sheminasalam/OverKill-Smart-IR-Hub/hardware/Overkill_marketing_collage.png

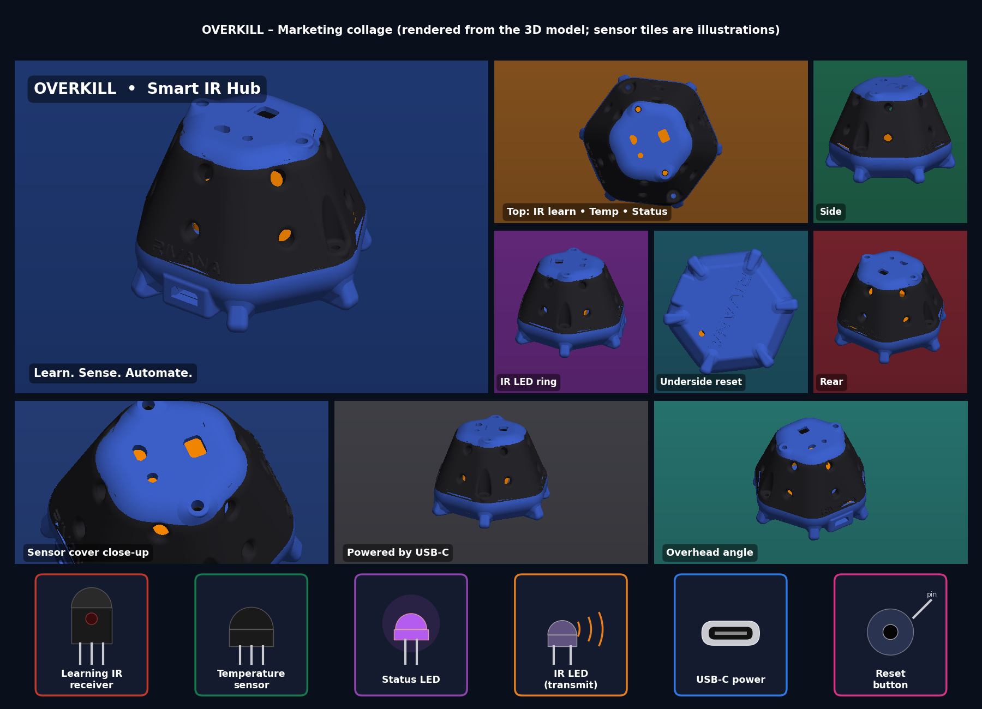
hardware/Overkill_marketing_collage.png
