sheminasalam/OverKill-Smart-IR-Hub/3d_printing/Overkill.3mf

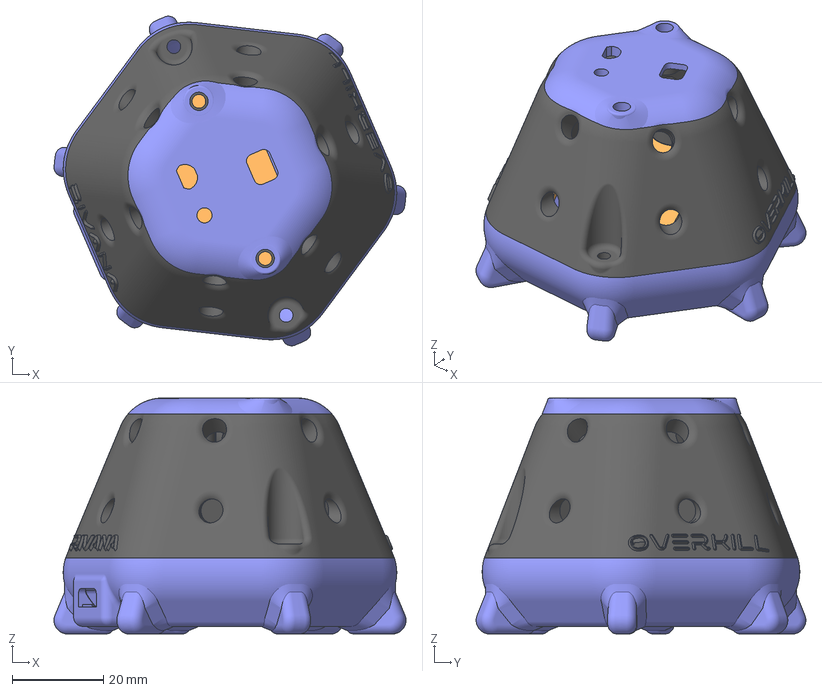
[picture p4: CAD file, 2026-10-25]
3d_printing/Overkill.3mf
77.1 x 72.2 x 51.7 mm
