sheminasalam/OverKill-Smart-IR-Hub/firmware/OverKill-v1.ino

#include <Arduino.h>
#include <EEPROM.h>
#include <ESP8266WiFi.h>
#include <WiFiUdp.h>
#include <PubSubClient.h>
#include <cstring>
#include <cstddef>
#include <cstdlib>
#include <SPI.h>
#include <IRremoteESP8266.h>
#include <IRrecv.h>
#include <IRsend.h>
#include <IRutils.h>
#include <time.h>
#include <ESP8266WebServer.h>
#include <ESP8266HTTPUpdateServer.h>
#include "captive_dns.h"
// >>> v11 INTEGRATION
#include "webui_html.h"

struct DatabaseHeader;
struct StorageRecordHeader;
struct FormatIntent;
enum class StableReadResult : uint8_t;
enum class PayloadVerifyResult : uint8_t;
enum class FormatIntentFindResult : uint8_t;
enum class DeviceLookupResult : uint8_t;
struct HueCommandMapEntry;
struct RuleStep;
struct RuleTriggerStored;
struct StoredRule;
struct LegacyStoredRule;
struct RuleTriggerRuntime;
struct RuleSlot;
struct StoredSchedule;
struct AutomationScheduleState;
struct AutomationJob;

#ifndef _IRREMOTEESP8266_VERSION
  #error "IRremoteESP8266 version macro not found. Install IRremoteESP8266 v2.9.0."
#endif
static_assert(
  _IRREMOTEESP8266_VERSION == _IRREMOTEESP8266_VERSION_VAL(2, 9, 0),
  "Stage 1 requires IRremoteESP8266 v2.9.0"
);

#define FIRMWARE_NAME    "ESP8266 Universal IR Hub"
#define FIRMWARE_VERSION "Overkill v2.0"

#define STAGE1_SERIAL_DEBUG 1

bool serialEnabled = true;

#if STAGE1_SERIAL_DEBUG
  #define DBG_PRINT(...)      do { if (serialEnabled) Serial.print(__VA_ARGS__); } while (0)
  #define DBG_PRINTLN(...)    do { if (serialEnabled) Serial.println(__VA_ARGS__); } while (0)
  #define DBG_PRINTLN_EMPTY() do { if (serialEnabled) Serial.println(); } while (0)
#else
  #define DBG_PRINT(...)      do {} while (0)
  #define DBG_PRINTLN(...)    do {} while (0)
  #define DBG_PRINTLN_EMPTY() do {} while (0)
#endif

// ============================================================
// FINAL GPIO ASSIGNMENT
// ============================================================

constexpr uint8_t PIN_FLASH_MISO   = 12;
constexpr uint8_t PIN_FLASH_MOSI   = 13;
constexpr uint8_t PIN_FLASH_SCLK   = 14;
constexpr uint8_t PIN_FLASH_CS     = 3;

constexpr uint8_t PIN_IR_TX_DEFAULT      = 4;
constexpr uint8_t PIN_IR_RX_DEFAULT      = 5;
constexpr uint8_t PIN_STATUS_LED_DEFAULT = 2;
constexpr uint8_t PIN_DS18B20_DEFAULT    = 16;

uint8_t pinIrTx      = PIN_IR_TX_DEFAULT;
uint8_t pinIrRx      = PIN_IR_RX_DEFAULT;
uint8_t pinStatusLed = PIN_STATUS_LED_DEFAULT;
uint8_t pinDs18b20   = PIN_DS18B20_DEFAULT;

static_assert(PIN_FLASH_MISO != PIN_FLASH_MOSI, "GPIO overlap");
static_assert(PIN_FLASH_MISO != PIN_FLASH_SCLK, "GPIO overlap");
static_assert(PIN_FLASH_MISO != PIN_FLASH_CS, "GPIO overlap");
static_assert(PIN_FLASH_MOSI != PIN_FLASH_SCLK, "GPIO overlap");
static_assert(PIN_FLASH_MOSI != PIN_FLASH_CS, "GPIO overlap");
static_assert(PIN_FLASH_SCLK != PIN_FLASH_CS, "GPIO overlap");

// ============================================================
// IR RECEIVER CONFIGURATION
// ============================================================

constexpr uint16_t RAW_WAVEFORM_CAPACITY = 1024;
constexpr uint16_t IRRECV_BUFFER_SIZE = RAW_WAVEFORM_CAPACITY + 1;
constexpr uint16_t CAPTURE_TIMEOUT_MS = 50;
constexpr bool     SAVE_BUFFER         = false;

static_assert(CAPTURE_TIMEOUT_MS <= UINT8_MAX,
              "CAPTURE_TIMEOUT_MS exceeds IRremoteESP8266 uint8_t limit");

constexpr uint32_t LEARN_SESSION_TIMEOUT_MS = 15000UL;

uint16_t txFrequencyHz = 38000;
uint8_t  txRepeatCount = 1;
uint16_t txRepeatGapMs = 100;

constexpr uint16_t MIN_TX_FREQUENCY_HZ = 10000;
constexpr uint16_t MAX_TX_FREQUENCY_HZ = UINT16_MAX;

constexpr uint16_t TX_WDT_FEED_INTERVAL = 16;
static_assert(TX_WDT_FEED_INTERVAL > 0,
              "TX_WDT_FEED_INTERVAL must be greater than zero");

IRrecv *irrecvPtr = nullptr;
IRsend *irsendPtr = nullptr;
decode_results results;
bool irReceiverActive = false;

enum class IrEngineState : uint8_t {
  IDLE,
  LEARNING,
  TRANSMITTING
};
IrEngineState irState = IrEngineState::IDLE;

static uint16_t lastRaw[RAW_WAVEFORM_CAPACITY];
uint16_t lastRawLen = 0;
uint32_t lastRawCrc32 = 0;

// Shared staging buffer used by both the IR capture path (during learn)
// and the storage record path (during load/save/rename). The two
// subsystems are active at different times, so a single aligned buffer
// replaces what used to be two separate 2 KB buffers (stagingRaw plus
// storageRecordBuffer). Sized for the maximum storage record: header
// + name + 1024-word waveform. The exact value is verified by a
// static_assert() in the storage section further down.
static constexpr size_t SHARED_RECORD_BUFFER_BYTES = 2123;
alignas(4) static uint8_t storageRecordBuffer[SHARED_RECORD_BUFFER_BYTES];

// Metadata captured at the same moment as a successful IR learn. This keeps
// the command's transmit parameters tied to the learned waveform instead of
// whatever happens to be in the mutable TX globals when the save occurs.
static uint16_t lastLearnCarrierHz = 38000U;
static uint8_t  lastLearnRepeatCount = 1U;
static uint16_t lastLearnRepeatGapMs = 100U;
static bool     lastLearnMetadataValid = false;

struct IrStatistics {
  uint32_t learnAttempts = 0;
  uint32_t successfulLearns = 0;
  uint32_t learnTimeouts = 0;
  uint32_t learnOverflows = 0;
  uint32_t malformedCaptures = 0;
  uint32_t storeFailures = 0;
  uint32_t transmissionsStarted = 0;
  uint32_t transmissionsCompleted = 0;
  uint32_t transmissionRejected = 0;
  uint16_t maxCapturedRawLen = 0;
  uint16_t maxStoredRawLen = 0;
  uint32_t maxWaveformDurationUs = 0;
};
IrStatistics irStats;

#if STAGE1_SERIAL_DEBUG
uint32_t minFreeHeap = UINT32_MAX;
#endif

// ============================================================
// STAGE 3 HARDWARE SERVICES
// ============================================================

constexpr bool     DS18B20_ENABLED_DEFAULT = true;
constexpr uint32_t DS18B20_SAMPLE_INTERVAL_DEFAULT_MS = 10000UL;
constexpr uint32_t DS18B20_SAMPLE_INTERVAL_MIN_MS = 1000UL;
constexpr uint32_t DS18B20_SAMPLE_INTERVAL_MAX_MS = 3600000UL;
constexpr uint32_t DS18B20_CONVERSION_WAIT_MS = 800UL;
constexpr uint32_t DS18B20_RETRY_INTERVAL_MS = 5000UL;

struct DS18B20State {
  bool enabled = DS18B20_ENABLED_DEFAULT;
  bool connected = false;
  bool conversionPending = false;
  bool temperatureValid = false;
  int16_t rawTemperature = 0;
  int16_t calibrationCentiDegrees = 0;
  int32_t calibratedTemperatureCentiDegrees = 0;
  uint32_t conversionStartedMs = 0;
  uint32_t sampleIntervalMs = DS18B20_SAMPLE_INTERVAL_DEFAULT_MS;
  uint32_t nextActionMs = 0;
  uint32_t lastReadMs = 0;
  uint32_t sampleSequence = 0;
};
DS18B20State ds18b20State;

enum class StatusLedMode : uint8_t { OFF, LEARNING, ERROR };
StatusLedMode statusLedMode = StatusLedMode::OFF;
bool statusLedOn = false;
bool statusLedPulsePending = false;
bool statusLedErrorActive = false;
bool statusLedManualErrorActive = false;
bool statusLedStorageErrorActive = false;
bool statusLedWifiErrorActive = false;
bool statusLedMqttErrorActive = false;
uint32_t statusLedNextToggleMs = 0;
uint32_t statusLedPulseUntilMs = 0;


enum class WifiRecoveryState : uint8_t { OFF, AP };
enum class DiscoveryMode : uint8_t { NATIVE_HA = 0, CUSTOM = 1 };
DiscoveryMode discoveryMode = DiscoveryMode::CUSTOM;
void mqttSetDiscoveryMode(DiscoveryMode mode);
void mqttClearAllDiscoveryRetained();
void mqttClearAlexaCatalogRetained();
WifiRecoveryState wifiRecoveryState = WifiRecoveryState::OFF;
uint32_t wifiRecoveryNotConnectedSinceMs = 0UL;
char     wifiRecoveryApSsid[24] = {0};
uint32_t wifiRecoveryApConnectedAtMs = 0UL;   // 0 = not yet connected
constexpr uint32_t WIFI_AP_GRACE_PERIOD_MS = 300000UL;   // 5 minutes

constexpr uint32_t WIFI_RECOVERY_TRIGGER_MS = 30000UL;

constexpr uint32_t STATUS_LED_LEARN_BLINK_MS = 300UL;
constexpr uint32_t STATUS_LED_ERROR_BLINK_MS = 1000UL;
constexpr uint32_t STATUS_LED_TX_PULSE_MS = 120UL;

void statusLedInitialize();
void statusLedSetError(bool active);
void statusLedSetStorageError(bool active);
void statusLedSetWifiError(bool active);
void statusLedSetMqttError(bool active);
void statusLedStartLearning();
void statusLedStopLearning();
void statusLedPulseTransmit();
void statusLedService();
void statusLedServiceLearningWait();
void statusLedServiceWifiErrorDelay();   // >>> v1.0 delayed WiFi error LED
void statusLedPrintStatus();
void rebootDevice();

// ============================================================
// WI-FI FOUNDATION
// ============================================================

constexpr size_t WIFI_SSID_MAX_LENGTH = 32U;
constexpr size_t WIFI_PASSWORD_MAX_LENGTH = 63U;
constexpr size_t WIFI_HOSTNAME_MAX_LENGTH = 32U;
constexpr uint32_t WIFI_CONNECT_TIMEOUT_MS = 15000UL;
constexpr uint32_t WIFI_RECONNECT_INTERVAL_MS = 5000UL;

enum class WifiState : uint8_t {
  UNCONFIGURED, CONNECTING, CONNECTED, DISCONNECTED
};

struct WifiConfiguration {
  char ssid[WIFI_SSID_MAX_LENGTH + 1U] = {0};
  char password[WIFI_PASSWORD_MAX_LENGTH + 1U] = {0};
  char hostname[WIFI_HOSTNAME_MAX_LENGTH + 1U] = {0};
};

struct StaticIpConfig {
  bool      enabled = false;
  IPAddress ip;
  IPAddress gateway;
  IPAddress subnet;
  IPAddress dns;
};
StaticIpConfig staticIpConfig;
static bool lastAppliedStaticIpMode = false;

// ── WebUI hub name (shared by WebUI and MQTT discovery) ─────
constexpr size_t WEBUI_HUB_NAME_MAX = 32U;
char webUiHubName[WEBUI_HUB_NAME_MAX + 1U] = "Universal IR Hub";


WifiConfiguration wifiConfig;
WifiState wifiState = WifiState::UNCONFIGURED;
bool wifiConnectAttemptActive = false;
// ── Wi-Fi recovery AP state (v1.0) ───────────────────────────
bool wifiConfigurationDirty = false;
uint32_t wifiConnectStartedMs = 0UL;
uint32_t wifiNextReconnectMs = 0UL;
uint8_t wifiLastStatus = 0U;

void wifiInitialize();
void wifiService();
void wifiPrintStatus();
bool wifiSetSSID(const char *ssid);
bool wifiSetPassword(const char *password);
bool wifiSetHostname(const char *hostname);
bool wifiApplyConfiguration();
bool wifiIsConfigured();
bool wifiIsConnected();
const char *wifiGetSSID();
bool wifiPasswordIsConfigured();
int32_t wifiGetRSSI();

void configurationStorageInitialize();
bool configurationLoadWifi();
bool configurationSaveWifi();
bool configurationLoadMqtt();
bool configurationLoadStaticIp();          // ← new
bool configurationSaveStaticIp();          // ← new
bool configurationSaveMqtt();
bool configurationLoadHa();
bool configurationSaveHa();
bool configurationLoadPins();
bool configurationSavePins();
bool configurationLoadSystem();
bool configurationSaveSystem();
bool configurationInitializeCommandHue(uint32_t databaseGeneration);
bool storageGetCommandHueEnabled(uint32_t commandId, bool &enabledOut);
bool storageSetCommandHueEnabled(uint32_t commandId, bool enabled);
bool configurationInitializeDeviceCloud(uint32_t databaseGeneration);
bool storageGetDeviceCloud(uint32_t deviceId, uint8_t &categoryOut, bool &cloudOut);
bool storageSetDeviceCloud(uint32_t deviceId, uint8_t category, bool cloud);
const char *deviceCategoryName(uint8_t category);
uint8_t deviceCategoryFromName(const char *name);
void hueInvalidateCache();
bool configurationLoadTempCal();
bool configurationSaveTempCal();

void hueInitialize();
void hueService();
void hueStopNetworking();   // >>> v1.0 watchdog needs this declared early

void mqttRequestDiscoveryRefresh();
bool mqttDiscoveryClearAllCommandConfigs();
bool mqttRemoveHaTemperatureDiscovery();
bool mqttRemoveHaButtonDiscovery(uint32_t commandId);   // >>> ADD

void mqttInitialize();
void mqttService();
void mqttPrintStatus();
bool mqttSetEnabled(bool enabled);
bool mqttSetBroker(const char *broker);
bool mqttSetPort(uint16_t port);
bool mqttSetUsername(const char *username);
bool mqttSetPassword(const char *password);
bool mqttSetClientId(const char *clientId);
bool mqttSetBaseTopic(const char *baseTopic);
bool mqttApplyConfiguration();
bool mqttIsConnected();
const char *mqttGetBaseTopic();
bool mqttHaDiscoverySetEnabled(bool enabled);

// >>> v11 INTEGRATION — WebUI forward declarations
bool webUiLoadHubName();
bool webUiPersistHubName();
const char *webUiIrStateToString(IrEngineState state);
bool parseUint32Text(const char *text, uint32_t &valueOut);
bool webUiParseAutomationCommand(const char *cmd, char *errOut, size_t errCap);
bool webUiDispatch(WiFiClient &client, const char *method, const char *path, const char *body);
// Used by the WiFi watchdog to avoid false positives during a scan.
bool webUiWifiScanInProgress();

// Config backup / restore to the W25Qxx flash.
bool storageWriteConfigBackup();
bool storageReadConfigBackup(uint8_t *out, size_t capacity);

// Per-entity settings on SPI (Stage 2 live path).
bool storageGetDeviceSettings(uint32_t deviceId, uint8_t &categoryOut, bool &cloudOut);
bool storageSetDeviceSettings(uint32_t deviceId, uint8_t category, bool cloud);
bool storageGetCommandAlexa(uint32_t commandId, bool &alexaOut);
bool storageSetCommandAlexa(uint32_t commandId, bool alexaOn);

bool copyWifiField(char *destination, size_t destinationCapacity, const char *source) {
  if (destination == nullptr || source == nullptr || destinationCapacity < 2U) return false;
  const size_t length = strlen(source);
  if (length == 0U || length >= destinationCapacity) return false;
  memcpy(destination, source, length + 1U);
  return true;
}

bool wifiHostnameIsValid(const char *hostname) {
  if (hostname == nullptr) return false;
  const size_t length = strlen(hostname);
  if (length == 0U || length > WIFI_HOSTNAME_MAX_LENGTH) return false;
  if (hostname[0] == '-' || hostname[length - 1U] == '-') return false;
  for (size_t i = 0; i < length; i++) {
    const char c = hostname[i];
    const bool valid = (c >= 'a' && c <= 'z') || (c >= 'A' && c <= 'Z') ||
                       (c >= '0' && c <= '9') || c == '-';
    if (!valid) return false;
  }
  return true;
}

const char *wifiStateToString(WifiState state) {
  switch (state) {
    case WifiState::UNCONFIGURED: return "UNCONFIGURED";
    case WifiState::CONNECTING:   return "CONNECTING";
    case WifiState::CONNECTED:    return "CONNECTED";
    case WifiState::DISCONNECTED: return "DISCONNECTED";
    default:                      return "UNKNOWN";
  }
}

void wifiUpdateStateFromHardware() {
  if (wifiConfig.ssid[0] == '\0') { wifiState = WifiState::UNCONFIGURED; return; }
  const wl_status_t currentStatus = WiFi.status();
  wifiLastStatus = static_cast<uint8_t>(currentStatus);
  if (currentStatus == WL_CONNECTED) {
    wifiState = WifiState::CONNECTED;
    wifiConnectAttemptActive = false;
  } else if (wifiConnectAttemptActive) {
    wifiState = WifiState::CONNECTING;
  } else {
    wifiState = WifiState::DISCONNECTED;
  }
}

static void wifiApplyIpConfiguration() {
  const bool useStatic = staticIpConfig.enabled &&
      static_cast<uint32_t>(staticIpConfig.ip) != 0U &&
      static_cast<uint32_t>(staticIpConfig.gateway) != 0U &&
      static_cast<uint32_t>(staticIpConfig.subnet) != 0U;
  if (useStatic) {
    const IPAddress dns = (static_cast<uint32_t>(staticIpConfig.dns) != 0U)
                          ? staticIpConfig.dns : staticIpConfig.gateway;
    if (!WiFi.config(staticIpConfig.ip, staticIpConfig.gateway,
                     staticIpConfig.subnet, dns)) {
      Serial.println(F("WARNING: static IP config rejected; using DHCP instead."));
    }
  } else {
    // Do NOT call WiFi.config(0,0,0,0) here. On ESP8266 core that does
    // not reliably revert a previously-latched static IP. The netif reset
    // in wifiStartConnection() handles the DHCP case instead.
  }
}

void wifiStartConnection() {
  if (wifiConfig.ssid[0] == '\0') {
    wifiConnectAttemptActive = false;
    wifiState = WifiState::UNCONFIGURED;
    statusLedSetWifiError(false);
    return;
  }

  // Detect IP-mode change. On ESP8266 a previously-applied static IP stays
  // latched in LwIP even across WiFi.disconnect(). The only reliable way to
  // switch between static and DHCP is a full netif reset via mode(WIFI_OFF).
  const bool wantStatic = staticIpConfig.enabled &&
      static_cast<uint32_t>(staticIpConfig.ip) != 0U &&
      static_cast<uint32_t>(staticIpConfig.gateway) != 0U &&
      static_cast<uint32_t>(staticIpConfig.subnet) != 0U;
  if (wantStatic != lastAppliedStaticIpMode) {
    WiFi.persistent(false);
    WiFi.disconnect(true);
    delay(100);
    WiFi.mode(WIFI_OFF);
    delay(100);
  }
  lastAppliedStaticIpMode = wantStatic;

  WiFi.mode((wifiRecoveryState != WifiRecoveryState::OFF) ? WIFI_AP_STA : WIFI_STA);
  WiFi.setSleepMode(WIFI_NONE_SLEEP);
  WiFi.hostname(wifiConfig.hostname);
  WiFi.disconnect();
  delay(1);

  wifiApplyIpConfiguration();

  WiFi.begin(wifiConfig.ssid, wifiConfig.password);
  wifiConnectAttemptActive = true;
  wifiConnectStartedMs = millis();
  wifiNextReconnectMs = 0UL;
  wifiLastStatus = static_cast<uint8_t>(WiFi.status());
  wifiState = WifiState::CONNECTING;
}

void wifiInitialize() {
  wifiConfig = WifiConfiguration{};
  snprintf(wifiConfig.hostname, sizeof(wifiConfig.hostname),
           "ir-hub-%06X",
           static_cast<unsigned int>(ESP.getChipId() & 0xFFFFFFUL));
  (void)configurationLoadWifi();
  WiFi.persistent(false);
  WiFi.mode(WIFI_OFF);
  wifiState = WifiState::UNCONFIGURED;
  wifiConnectAttemptActive = false;
  wifiConfigurationDirty = false;
  wifiConnectStartedMs = 0UL;
  wifiNextReconnectMs = 0UL;
  wifiLastStatus = static_cast<uint8_t>(WiFi.status());
  statusLedSetWifiError(false);
}

bool wifiStatusIndicatesConnectionFailure(wl_status_t status) {
  if (status == WL_CONNECT_FAILED || status == WL_NO_SSID_AVAIL) return true;
#ifdef WL_CONNECT_WRONG_PASSWORD
  if (status == WL_CONNECT_WRONG_PASSWORD) return true;
#endif
  return false;
}

// ============================================================
// Wi-Fi liveness watchdog (v2)
// ============================================================
// The previous implementation probed the DHCP-provided DNS server with a
// hand-rolled UDP/53 packet. Home routers commonly drop or rewrite those
// packets, so the probe always timed out and the watchdog killed a healthy
// link every 15 seconds.
//
// This version:
//   * probes a well-known public NTP server by hardcoded IP (no DNS at all)
//   * sends one query every 30 s
//   * declares the link dead only after 3 consecutive misses (~90 s)
//   * refuses to fire if an HTTP client is mid-request
//   * resets state cleanly on every WiFi reconnect

WiFiUDP  wifiWatchdogUdp;
IPAddress wifiWatchdogTarget(162, 159, 200, 1);   // time.cloudflare.com (anycast)
bool     wifiWatchdogSocketOpen        = false;
uint32_t wifiWatchdogLastSendMs        = 0UL;
uint32_t wifiWatchdogLastRecvMs        = 0UL;
uint8_t  wifiWatchdogConsecutiveMisses = 0U;
bool     wifiWatchdogProbeOutstanding  = false;   // >>> v1.0 tighter watchdog

constexpr uint32_t WIFI_WATCHDOG_SEND_INTERVAL_MS = 30000UL;  // 30 s between probes
constexpr uint32_t WIFI_WATCHDOG_RECV_TIMEOUT_MS  = 30000UL;  // reply window
constexpr uint8_t  WIFI_WATCHDOG_MAX_MISSES       = 3U;       // 3 × 30 s ≈ 90 s

// Declared in the Hue module; true when an HTTP client is being served.
extern bool hueHttpClientActive;

void wifiForceHardReset() {
  Serial.println(F("WiFi watchdog: forcing hard reassociation"));
  WiFi.disconnect(true);
  delay(100);
  WiFi.mode(WIFI_OFF);
  delay(100);
  WiFi.mode(WIFI_STA);
  WiFi.setSleepMode(WIFI_NONE_SLEEP);
  if (wifiConfig.hostname[0] != '\0') WiFi.hostname(wifiConfig.hostname);
  wifiApplyIpConfiguration();
  lastAppliedStaticIpMode = staticIpConfig.enabled &&
      static_cast<uint32_t>(staticIpConfig.ip) != 0U;
  WiFi.begin(wifiConfig.ssid, wifiConfig.password);
  wifiConnectAttemptActive      = true;
  wifiConnectStartedMs          = millis();
  wifiNextReconnectMs           = 0UL;
  wifiState                     = WifiState::CONNECTING;
  wifiWatchdogSocketOpen        = false;
  wifiWatchdogLastSendMs        = 0UL;
  wifiWatchdogLastRecvMs        = 0UL;
  wifiWatchdogConsecutiveMisses = 0U;
  hueStopNetworking();
}

void wifiWatchdogSendNtpProbe() {
  if (!wifiWatchdogSocketOpen) {
    if (!wifiWatchdogUdp.begin(0)) return;
    wifiWatchdogSocketOpen = true;
  }
  // Minimal NTPv4 client request: LI=0, VN=4, Mode=3 → 0x23.
  // All other fields zero, which is acceptable for a liveness probe.
  uint8_t packet[48] = {0};
  packet[0] = 0x23;
  wifiWatchdogUdp.beginPacket(wifiWatchdogTarget, 123);
  wifiWatchdogUdp.write(packet, sizeof(packet));
  wifiWatchdogUdp.endPacket();
}

void wifiWatchdogService() {
  // Never touch WiFi while an OTA update is in flight. The transfer
  // saturates the radio, so NTP probes cannot be answered inside the
  // 30 s window and the watchdog would force-reset WiFi mid-upload.
  if (Update.isRunning()) {
    wifiWatchdogConsecutiveMisses = 0U;
    wifiWatchdogProbeOutstanding  = false;
    wifiWatchdogLastSendMs        = millis();
    return;
  }
  // WiFi scan parks the radio on one channel at a time. NTP replies
  // arriving on a different channel are missed. Treat a scan in
  // progress as "radio busy" and hold the miss counter.
  if (webUiWifiScanInProgress()) {
    wifiWatchdogConsecutiveMisses = 0U;
    wifiWatchdogProbeOutstanding  = false;
    wifiWatchdogLastSendMs        = millis();
    return;
  }
  if (!wifiIsConnected()) {
    wifiWatchdogSocketOpen        = false;
    wifiWatchdogLastSendMs        = 0UL;
    wifiWatchdogLastRecvMs        = 0UL;
    wifiWatchdogConsecutiveMisses = 0U;
    wifiWatchdogProbeOutstanding  = false;
    return;
  }

  const uint32_t now = millis();

  // First tick after a successful connect: seed timers, send a probe now.
  if (wifiWatchdogLastRecvMs == 0UL) {
    wifiWatchdogLastRecvMs = now;
    wifiWatchdogLastSendMs = now - WIFI_WATCHDOG_SEND_INTERVAL_MS;
    return;
  }

  // Any datagram back = link alive. Clear the miss counter and mark the
  // outstanding probe as answered.
  if (wifiWatchdogSocketOpen && wifiWatchdogUdp.parsePacket() > 0) {
    while (wifiWatchdogUdp.available()) (void)wifiWatchdogUdp.read();
    if (wifiWatchdogConsecutiveMisses > 0U) {
      Serial.print(F("WiFi watchdog: link recovered after "));
      Serial.print(wifiWatchdogConsecutiveMisses);
      Serial.println(F(" unanswered probe(s)"));
    }
    wifiWatchdogConsecutiveMisses = 0U;
    wifiWatchdogProbeOutstanding  = false;
  }

  // Time to send the next probe?
  if ((now - wifiWatchdogLastSendMs) >= WIFI_WATCHDOG_SEND_INTERVAL_MS) {
    // If the previous probe was never answered by now, count one miss.
    if (wifiWatchdogProbeOutstanding) {
      wifiWatchdogConsecutiveMisses++;
      Serial.print(F("WiFi watchdog: probe miss "));
      Serial.print(wifiWatchdogConsecutiveMisses);
      Serial.print('/');
      Serial.println(WIFI_WATCHDOG_MAX_MISSES);

      if (wifiWatchdogConsecutiveMisses >= WIFI_WATCHDOG_MAX_MISSES) {
        if (hueHttpClientActive || Update.isRunning()) {
          // Do not kill an in-flight HTTP request or OTA write.
          wifiWatchdogConsecutiveMisses = WIFI_WATCHDOG_MAX_MISSES - 1U;
        } else {
          wifiForceHardReset();
          return;
        }
      }
    }

    wifiWatchdogLastSendMs        = now;
    wifiWatchdogSendNtpProbe();
    wifiWatchdogProbeOutstanding  = true;
  }
}

void wifiStartRecoveryAp() {
  if (wifiRecoveryState != WifiRecoveryState::OFF) return;

  snprintf(wifiRecoveryApSsid, sizeof(wifiRecoveryApSsid),
           "Overkill-%06X", (unsigned)(ESP.getChipId() & 0xFFFFFFUL));

  WiFi.mode(WIFI_AP_STA);
  WiFi.setSleepMode(WIFI_NONE_SLEEP);
  WiFi.softAP(wifiRecoveryApSsid);
  captiveDnsStart();

  wifiRecoveryState = WifiRecoveryState::AP;
  hueStopNetworking();

  Serial.print(F("Recovery AP started: "));
  Serial.print(wifiRecoveryApSsid);
  Serial.print(F(" @ "));
  Serial.println(WiFi.softAPIP());
}

// Runs on every idle tick of wifiService(), regardless of STA state.
// The teardown must not live at the end of wifiService() because the
// WL_CONNECTED branch returns early.
static void wifiServiceApGracePeriod() {
  if (wifiRecoveryState == WifiRecoveryState::OFF) return;
  if (wifiRecoveryApConnectedAtMs == 0UL) return;
  if (Update.isRunning()) return;   // never tear down mid-OTA
  const uint32_t now = millis();
  if ((now - wifiRecoveryApConnectedAtMs) < WIFI_AP_GRACE_PERIOD_MS) return;

  hueStopNetworking();          // close HTTP + SSDP first
  captiveDnsStop();             // close captive DNS UDP
  WiFi.softAPdisconnect(true);  // turn the AP off
  WiFi.mode(WIFI_STA);          // now safe to change mode
  WiFi.setSleepMode(WIFI_NONE_SLEEP);
  wifiRecoveryState = WifiRecoveryState::OFF;
  wifiRecoveryApConnectedAtMs = 0UL;
  Serial.println(F("Recovery AP grace period expired; AP stopped."));
}

void wifiService() {
  if (irState != IrEngineState::IDLE) return;
  wifiServiceApGracePeriod();
  if (wifiConfig.ssid[0] == '\0') {
    if (wifiState != WifiState::UNCONFIGURED) {
      WiFi.disconnect(); WiFi.mode(WIFI_OFF);
      wifiConnectAttemptActive = false;
      wifiState = WifiState::UNCONFIGURED;
    }
    statusLedSetWifiError(false);

    // ── v1.0: fresh device, no credentials — bring up AP after 10 s ──
    if (wifiRecoveryState == WifiRecoveryState::OFF) {
      const uint32_t now = millis();
      if (wifiRecoveryNotConnectedSinceMs == 0UL) {
        wifiRecoveryNotConnectedSinceMs = now;
      }
      if ((now - wifiRecoveryNotConnectedSinceMs) >= 10000UL) {
        wifiStartRecoveryAp();
      }
    }
    return;
  }
  const uint32_t now = millis();
  const wl_status_t currentStatusBeforeDirtyCheck = WiFi.status();
  wifiLastStatus = static_cast<uint8_t>(currentStatusBeforeDirtyCheck);
  if (wifiConfigurationDirty) {
    if (currentStatusBeforeDirtyCheck == WL_CONNECTED) {
      wifiConnectAttemptActive = false; wifiState = WifiState::CONNECTED;
    } else {
      wifiConnectAttemptActive = false; wifiState = WifiState::DISCONNECTED;
    }
    statusLedSetWifiError(false);
    return;
  }
  const wl_status_t currentStatus = WiFi.status();
// ── Continuous-disconnect tracking ───────────────────────────
if (currentStatus == WL_CONNECTED) {
  wifiRecoveryNotConnectedSinceMs = 0UL;
  if (wifiRecoveryState != WifiRecoveryState::OFF) {
    // Keep the AP alive for a grace period after STA connects so the user,
    // still attached to the AP, can read the new LAN IP from the AP page.
    // We record the moment STA connected and let wifiService() tear the AP
    // down later (see the AP grace-period block further down this function).
    if (wifiRecoveryApConnectedAtMs == 0UL) {
      wifiRecoveryApConnectedAtMs = now;
      Serial.print(F("STA connected on IP "));
      Serial.println(WiFi.localIP());
      Serial.println(F("Recovery AP kept alive so you can read the IP above."));
    }
  }
} else if (wifiRecoveryNotConnectedSinceMs == 0UL) {
  wifiRecoveryNotConnectedSinceMs = now;
}

// ── Trigger AP after 30 s continuous outage ──────────────────
if (!Update.isRunning() &&
    wifiRecoveryState == WifiRecoveryState::OFF &&
    currentStatus != WL_CONNECTED &&
    wifiRecoveryNotConnectedSinceMs != 0UL &&
    (now - wifiRecoveryNotConnectedSinceMs) >= WIFI_RECOVERY_TRIGGER_MS) {
  wifiStartRecoveryAp();
}
  wifiLastStatus = static_cast<uint8_t>(currentStatus);
  if (currentStatus == WL_CONNECTED) {
#if STAGE1_SERIAL_DEBUG
    const bool becameConnected = (wifiState != WifiState::CONNECTED);
#endif
    wifiConnectAttemptActive = false;
    wifiState = WifiState::CONNECTED;
    WiFi.setSleepMode(WIFI_NONE_SLEEP);
    statusLedSetWifiError(false);
#if STAGE1_SERIAL_DEBUG
    if (becameConnected && serialEnabled) {
      Serial.print(F("Wi-Fi connected. IP: "));
      Serial.println(WiFi.localIP());
    }
#endif
    return;
  }
  //statusLedSetWifiError(true);
  if (wifiConnectAttemptActive) {
    wifiState = WifiState::CONNECTING;
    if (wifiStatusIndicatesConnectionFailure(currentStatus) ||
        (now - wifiConnectStartedMs) >= WIFI_CONNECT_TIMEOUT_MS) {
      WiFi.disconnect();
      wifiConnectAttemptActive = false;
      wifiState = WifiState::DISCONNECTED;
      wifiNextReconnectMs = now + WIFI_RECONNECT_INTERVAL_MS;
    }
    return;
  }
  wifiState = WifiState::DISCONNECTED;
  if (static_cast<int32_t>(now - wifiNextReconnectMs) >= 0) {
    wifiStartConnection();
  }

}

bool wifiSetSSID(const char *ssid) {
  if (ssid == nullptr || strlen(ssid) > WIFI_SSID_MAX_LENGTH) return false;
  if (ssid[0] == '\0') {
    memset(wifiConfig.ssid, 0, sizeof(wifiConfig.ssid));
    WiFi.disconnect(); WiFi.mode(WIFI_OFF);
    wifiConnectAttemptActive = false;
    wifiConfigurationDirty = false;
    wifiState = WifiState::UNCONFIGURED;
    statusLedSetWifiError(false);
    if (!configurationSaveWifi()) {
      Serial.println(F("WARNING: Wi-Fi SSID was cleared in RAM but the cleared state could not be persisted."));
    }
    return true;
  }
  if (!copyWifiField(wifiConfig.ssid, sizeof(wifiConfig.ssid), ssid)) return false;
  wifiConfigurationDirty = true;
  wifiConnectAttemptActive = false;
  if (WiFi.status() != WL_CONNECTED) wifiState = WifiState::DISCONNECTED;
  else wifiState = WifiState::CONNECTED;
  statusLedSetWifiError(false);
  return true;
}

bool wifiSetPassword(const char *password) {
  if (password == nullptr || strlen(password) > WIFI_PASSWORD_MAX_LENGTH) return false;
  for (size_t i = 0; password[i] != '\0'; i++) {
    const uint8_t c = static_cast<uint8_t>(password[i]);
    if (c < 32U || c > 126U) return false;
  }
  memset(wifiConfig.password, 0, sizeof(wifiConfig.password));
  memcpy(wifiConfig.password, password, strlen(password) + 1U);
  wifiConfigurationDirty = true;
  return true;
}

bool wifiSetHostname(const char *hostname) {
  if (!wifiHostnameIsValid(hostname)) return false;
  if (!copyWifiField(wifiConfig.hostname, sizeof(wifiConfig.hostname), hostname)) return false;
  wifiConfigurationDirty = true;
  return true;
}

bool wifiApplyConfiguration() {
  if (wifiConfig.ssid[0] == '\0') {
    wifiConfigurationDirty = false;
    wifiState = WifiState::UNCONFIGURED;
    statusLedSetWifiError(false);
    return false;
  }
  if (!configurationSaveWifi()) {
    Serial.println(F("WARNING: Wi-Fi configuration applied in RAM but could not be persisted."));
  }
  wifiConfigurationDirty = false;
  wifiStartConnection();
  return true;
}

bool wifiIsConfigured() { return wifiConfig.ssid[0] != '\0'; }
bool wifiIsConnected() { return WiFi.status() == WL_CONNECTED; }
const char *wifiGetSSID() { return wifiConfig.ssid; }
bool wifiPasswordIsConfigured() { return wifiConfig.password[0] != '\0'; }
int32_t wifiGetRSSI() { return wifiIsConnected() ? static_cast<int32_t>(WiFi.RSSI()) : 0; }

void wifiPrintStatus() {
#if STAGE1_SERIAL_DEBUG
  if (!serialEnabled) return;
  wifiUpdateStateFromHardware();
  Serial.println();
  Serial.println(F("=== WI-FI ==="));
  Serial.print(F("Configured    : ")); Serial.println(wifiIsConfigured() ? F("YES") : F("NO"));
  Serial.print(F("Pending config: ")); Serial.println(wifiConfigurationDirty ? F("YES") : F("NO"));
  Serial.print(F("SSID          : ")); if (wifiIsConfigured()) Serial.println(wifiConfig.ssid); else Serial.println(F("<not set>"));
  Serial.print(F("Password      : ")); Serial.println(wifiPasswordIsConfigured() ? F("SET") : F("NOT SET"));
  Serial.print(F("Hostname      : ")); Serial.println(wifiConfig.hostname);
  Serial.print(F("State         : ")); Serial.println(wifiStateToString(wifiState));
  Serial.print(F("Status code   : ")); Serial.println(wifiLastStatus);
  Serial.print(F("RSSI          : "));
  if (wifiIsConnected()) {
    Serial.print(wifiGetRSSI()); Serial.println(F(" dBm"));
    Serial.print(F("IP address    : ")); Serial.println(WiFi.localIP());
  } else Serial.println(F("n/a"));
  Serial.print(F("MAC address   : ")); Serial.println(WiFi.macAddress());
  Serial.println(F("=============="));
  Serial.println();
#endif
}

// ============================================================
// TIME / NTP SERVICE
// ============================================================

constexpr uint32_t TIME_MIN_VALID_EPOCH   = 1600000000UL;
constexpr size_t   NTP_SERVER_MAX_LENGTH  = 63U;
constexpr uint32_t NTP_RETRY_INTERVAL_MS  = 60000UL;

bool     ntpEnabled          = true;
int16_t  ntpGmtOffsetMinutes = 0;
int16_t  ntpDstOffsetMinutes = 0;
char     ntpServer[NTP_SERVER_MAX_LENGTH + 1U] = "pool.ntp.org";

bool     ntpTimeValid     = false;
bool     ntpTimeAttempted = false;
uint32_t ntpLastAttemptMs = 0UL;

void timeInitialize();
void timeService();
void timePrintStatus();
void timeApplyConfig();
bool timeIsValid();
time_t timeNow();
bool timeGetLocal(struct tm &out);
bool timeSetEnabled(bool enabled);
bool timeSetServer(const char *server);
bool timeSetGmtOffset(int16_t minutes);
bool timeSetDstOffset(int16_t minutes);

bool timeIsValid() {
  return static_cast<uint32_t>(time(nullptr)) >= TIME_MIN_VALID_EPOCH;
}

time_t timeNow() { return time(nullptr); }

bool timeGetLocal(struct tm &out) {
  const time_t now = time(nullptr);
  if (static_cast<uint32_t>(now) < TIME_MIN_VALID_EPOCH) return false;
  localtime_r(&now, &out);
  return true;
}

void timeApplyConfig() {
  if (!ntpEnabled || !wifiIsConnected()) return;
  const long gmtSec = static_cast<long>(ntpGmtOffsetMinutes) * 60L;
  const long dstSec = static_cast<long>(ntpDstOffsetMinutes) * 60L;
  configTime(gmtSec, dstSec, ntpServer);
  ntpTimeAttempted = true;
  ntpLastAttemptMs = millis();
}

void timeInitialize() {
  ntpTimeValid     = false;
  ntpTimeAttempted = false;
  ntpLastAttemptMs = 0UL;
  if (ntpEnabled && wifiIsConnected()) timeApplyConfig();
}

void timeService() {
  if (!ntpEnabled) { ntpTimeValid = false; return; }
  if (!wifiIsConnected()) return;

  if (!timeIsValid()) {
    const uint32_t now = millis();
    if (!ntpTimeAttempted || (now - ntpLastAttemptMs) >= NTP_RETRY_INTERVAL_MS) {
      timeApplyConfig();
    }
    return;
  }
  if (!ntpTimeValid) {
    ntpTimeValid = true;
#if STAGE1_SERIAL_DEBUG
    if (serialEnabled) {
      struct tm t{};
      if (timeGetLocal(t)) {
        char buf[24] = {0};
        strftime(buf, sizeof(buf), "%Y-%m-%d %H:%M:%S", &t);
        Serial.print(F("Time synchronized: "));
        Serial.println(buf);
      }
    }
#endif
  }
}

bool timeSetEnabled(bool enabled) {
  ntpEnabled = enabled;
  ntpTimeAttempted = false;
  ntpLastAttemptMs = 0UL;
  if (!enabled) ntpTimeValid = false;
  else if (wifiIsConnected()) timeApplyConfig();
  return true;
}

bool timeSetServer(const char *server) {
  if (server == nullptr) return false;
  const size_t len = strlen(server);
  if (len == 0U || len > NTP_SERVER_MAX_LENGTH) return false;
  memcpy(ntpServer, server, len + 1U);
  ntpTimeAttempted = false;
  ntpLastAttemptMs = 0UL;
  if (ntpEnabled && wifiIsConnected()) timeApplyConfig();
  return true;
}

bool timeSetGmtOffset(int16_t minutes) {
  if (minutes < -1440 || minutes > 1440) return false;
  ntpGmtOffsetMinutes = minutes;
  ntpTimeAttempted = false;
  ntpLastAttemptMs = 0UL;
  if (ntpEnabled && wifiIsConnected()) timeApplyConfig();
  return true;
}

bool timeSetDstOffset(int16_t minutes) {
  if (minutes < 0 || minutes > 120) return false;
  ntpDstOffsetMinutes = minutes;
  ntpTimeAttempted = false;
  ntpLastAttemptMs = 0UL;
  if (ntpEnabled && wifiIsConnected()) timeApplyConfig();
  return true;
}

void timePrintStatus() {
#if STAGE1_SERIAL_DEBUG
  if (!serialEnabled) return;
  Serial.println();
  Serial.println(F("=== TIME / NTP ==="));
  Serial.print(F("NTP enabled : ")); Serial.println(ntpEnabled ? F("YES") : F("NO"));
  Serial.print(F("Server      : ")); Serial.println(ntpServer);
  Serial.print(F("GMT offset  : ")); Serial.print(ntpGmtOffsetMinutes); Serial.println(F(" min"));
  Serial.print(F("DST offset  : ")); Serial.print(ntpDstOffsetMinutes); Serial.println(F(" min"));  Serial.print(F("Wi-Fi       : ")); Serial.println(wifiIsConnected() ? F("CONNECTED") : F("NOT CONNECTED"));
  Serial.print(F("Time valid  : ")); Serial.println(timeIsValid() ? F("YES") : F("NO"));
  if (timeIsValid()) {
    struct tm t{};
    if (timeGetLocal(t)) {
      char buf[24] = {0};
      strftime(buf, sizeof(buf), "%Y-%m-%d %H:%M:%S", &t);
      Serial.print(F("Local time  : ")); Serial.println(buf);
    }
    Serial.print(F("Unix time   : ")); Serial.println(static_cast<unsigned long>(timeNow()));
  }
  Serial.println(F("=================="));
  Serial.println();
#endif
}

// ============================================================
// DS18B20 NATIVE 1-WIRE DRIVER
// ============================================================

void ds18b20ReleaseBus() { pinMode(pinDs18b20, INPUT); }

bool ds18b20ResetPresence() {
  bool presence = false;
  noInterrupts();
  pinMode(pinDs18b20, OUTPUT);
  digitalWrite(pinDs18b20, LOW);
  delayMicroseconds(480);
  pinMode(pinDs18b20, INPUT);
  delayMicroseconds(70);
  presence = (digitalRead(pinDs18b20) == LOW);
  delayMicroseconds(410);
  interrupts();
  return presence;
}

void ds18b20WriteBit(bool value) {
  noInterrupts();
  pinMode(pinDs18b20, OUTPUT);
  digitalWrite(pinDs18b20, LOW);
  if (value) {
    delayMicroseconds(6); ds18b20ReleaseBus(); delayMicroseconds(64);
  } else {
    delayMicroseconds(60); ds18b20ReleaseBus(); delayMicroseconds(10);
  }
  interrupts();
}

bool ds18b20ReadBit() {
  bool value = false;
  noInterrupts();
  pinMode(pinDs18b20, OUTPUT);
  digitalWrite(pinDs18b20, LOW);
  delayMicroseconds(3);
  ds18b20ReleaseBus();
  delayMicroseconds(10);
  value = (digitalRead(pinDs18b20) == HIGH);
  delayMicroseconds(53);
  interrupts();
  return value;
}

void ds18b20WriteByte(uint8_t value) {
  for (uint8_t bit = 0; bit < 8; ++bit) { ds18b20WriteBit((value & 0x01U) != 0U); value >>= 1; }
}

uint8_t ds18b20Crc8(const uint8_t *data, size_t length);

uint8_t ds18b20ReadByte() {
  uint8_t value = 0;
  for (uint8_t bit = 0; bit < 8; ++bit) if (ds18b20ReadBit()) value |= static_cast<uint8_t>(1U << bit);
  return value;
}

bool ds18b20ReadRomAndValidate() {
  uint8_t rom[8] = {0};
  if (!ds18b20ResetPresence()) return false;
  ds18b20WriteByte(0x33U);
  for (uint8_t i = 0; i < sizeof(rom); ++i) rom[i] = ds18b20ReadByte();
  if (rom[0] != 0x28U) return false;
  return ds18b20Crc8(rom, 7) == rom[7];
}

uint8_t ds18b20Crc8(const uint8_t *data, size_t length) {
  uint8_t crc = 0;
  if (data == nullptr) return 0;
  for (size_t i = 0; i < length; ++i) {
    uint8_t inByte = data[i];
    for (uint8_t bit = 0; bit < 8; ++bit) {
      const uint8_t mix = static_cast<uint8_t>((crc ^ inByte) & 0x01U);
      crc >>= 1;
      if (mix != 0U) crc ^= 0x8CU;
      inByte >>= 1;
    }
  }
  return crc;
}

bool ds18b20StartConversion() {
  if (!ds18b20State.connected && !ds18b20ReadRomAndValidate()) return false;
  if (!ds18b20ResetPresence()) return false;
  ds18b20WriteByte(0xCCU);
  ds18b20WriteByte(0x44U);
  return true;
}

bool ds18b20ReadTemperatureRaw(int16_t &rawTemperature) {
  uint8_t scratchpad[9] = {0};
  if (!ds18b20ResetPresence()) return false;
  ds18b20WriteByte(0xCCU);
  ds18b20WriteByte(0xBEU);
  for (uint8_t i = 0; i < sizeof(scratchpad); ++i) scratchpad[i] = ds18b20ReadByte();
  if (ds18b20Crc8(scratchpad, 8) != scratchpad[8]) return false;
  const uint16_t raw = static_cast<uint16_t>(scratchpad[0]) | (static_cast<uint16_t>(scratchpad[1]) << 8);
  const int16_t temperature = static_cast<int16_t>(raw);
  if (temperature < static_cast<int16_t>(-880) || temperature > static_cast<int16_t>(2000)) return false;
  rawTemperature = temperature;
  return true;
}

void ds18b20Service() {
  if (irState != IrEngineState::IDLE || !ds18b20State.enabled) return;
  const uint32_t now = millis();
  if (ds18b20State.conversionPending) {
    if ((now - ds18b20State.conversionStartedMs) < DS18B20_CONVERSION_WAIT_MS) return;
    ds18b20State.conversionPending = false;
    int16_t rawTemperature = 0;
    if (ds18b20ReadTemperatureRaw(rawTemperature)) {
      ds18b20State.rawTemperature = rawTemperature;
      ds18b20State.calibratedTemperatureCentiDegrees =
          (static_cast<int32_t>(rawTemperature) * 625L) / 100L +
          static_cast<int32_t>(ds18b20State.calibrationCentiDegrees);
      ds18b20State.temperatureValid = true;
      ds18b20State.connected = true;
      ds18b20State.lastReadMs = now;
      ds18b20State.sampleSequence++;
      ds18b20State.nextActionMs = now + ds18b20State.sampleIntervalMs;
    } else {
      ds18b20State.temperatureValid = false;
      ds18b20State.connected = false;
      ds18b20State.nextActionMs = now + DS18B20_RETRY_INTERVAL_MS;
    }
    return;
  }
  if (static_cast<int32_t>(now - ds18b20State.nextActionMs) < 0) return;
  if (ds18b20StartConversion()) {
    ds18b20State.conversionPending = true;
    ds18b20State.conversionStartedMs = now;
    ds18b20State.connected = true;
    return;
  }
  ds18b20State.temperatureValid = false;
  ds18b20State.connected = false;
  ds18b20State.nextActionMs = now + DS18B20_RETRY_INTERVAL_MS;
}

void ds18b20SetEnabled(bool enabled) {
  ds18b20State.enabled = enabled;
  ds18b20State.conversionPending = false;
  ds18b20State.temperatureValid = false;
  ds18b20State.connected = false;
  ds18b20State.nextActionMs = enabled ? 0UL : UINT32_MAX;
  ds18b20ReleaseBus();
}

void ds18b20SetCalibrationCentiDegrees(int16_t offsetCentiDegrees) {
  ds18b20State.calibrationCentiDegrees = offsetCentiDegrees;
  if (ds18b20State.temperatureValid) {
    ds18b20State.calibratedTemperatureCentiDegrees =
        (static_cast<int32_t>(ds18b20State.rawTemperature) * 625L) / 100L +
        static_cast<int32_t>(offsetCentiDegrees);
  }
}

void ds18b20SetSampleIntervalMs(uint32_t intervalMs) {
  if (intervalMs < DS18B20_SAMPLE_INTERVAL_MIN_MS) intervalMs = DS18B20_SAMPLE_INTERVAL_MIN_MS;
  else if (intervalMs > DS18B20_SAMPLE_INTERVAL_MAX_MS) intervalMs = DS18B20_SAMPLE_INTERVAL_MAX_MS;
  ds18b20State.sampleIntervalMs = intervalMs;
  if (ds18b20State.enabled && !ds18b20State.conversionPending && ds18b20State.temperatureValid) {
    ds18b20State.nextActionMs = ds18b20State.lastReadMs + intervalMs;
  }
}

bool ds18b20IsEnabled() { return ds18b20State.enabled; }
bool ds18b20IsConnected() { return ds18b20State.connected; }
bool ds18b20HasValidReading() { return ds18b20State.temperatureValid; }
uint32_t ds18b20GetSampleIntervalMs() { return ds18b20State.sampleIntervalMs; }
int32_t ds18b20GetCalibratedCentiDegrees() { return ds18b20State.calibratedTemperatureCentiDegrees; }
int16_t ds18b20GetCalibrationCentiDegrees() { return ds18b20State.calibrationCentiDegrees; }
uint32_t ds18b20GetSampleSequence() { return ds18b20State.sampleSequence; }

void ds18b20PrintStatus() {
#if STAGE1_SERIAL_DEBUG
  if (!serialEnabled) return;
  Serial.println();
  Serial.println(F("=== DS18B20 ==="));
  Serial.print(F("Enabled      : ")); Serial.println(ds18b20State.enabled ? F("YES") : F("NO"));
  Serial.print(F("GPIO         : GPIO")); Serial.println(pinDs18b20);
  Serial.print(F("Update int.   : ")); Serial.print(ds18b20State.sampleIntervalMs / 1000UL); Serial.println(F(" s"));
  Serial.print(F("Connected    : ")); Serial.println(ds18b20State.connected ? F("YES") : F("NO"));
  Serial.print(F("Conversion   : ")); Serial.println(ds18b20State.conversionPending ? F("IN PROGRESS") : F("IDLE"));
  Serial.print(F("Temperature  : "));
  if (!ds18b20State.temperatureValid) {
    Serial.println(F("UNAVAILABLE"));
  } else {
    const int32_t centiDegrees = ds18b20State.calibratedTemperatureCentiDegrees;
    const bool negative = centiDegrees < 0;
    const int32_t absoluteCenti = negative ? -centiDegrees : centiDegrees;
    if (negative) Serial.print('-');
    Serial.print(absoluteCenti / 100L); Serial.print('.');
    const int32_t fraction = absoluteCenti % 100L;
    if (fraction < 10L) Serial.print('0');
    Serial.print(fraction); Serial.println(F(" C (calibrated)"));
  }
  const int16_t offset = ds18b20State.calibrationCentiDegrees;
  const int32_t signedOffset = static_cast<int32_t>(offset);
  const bool offsetNegative = signedOffset < 0;
  const int32_t absoluteOffset = offsetNegative ? -signedOffset : signedOffset;
  Serial.print(F("Calibration  : "));
  if (offsetNegative) Serial.print('-');
  Serial.print(absoluteOffset / 100L); Serial.print('.');
  const int32_t offsetFraction = absoluteOffset % 100L;
  if (offsetFraction < 10L) Serial.print('0');
  Serial.print(offsetFraction); Serial.println(F(" C"));
  if (ds18b20State.temperatureValid) {
    Serial.print(F("Sample seq   : ")); Serial.println(ds18b20State.sampleSequence);
  }
  Serial.println(F("==============="));
  Serial.println();
#endif
}

// ============================================================
// SERIAL COMMAND INPUT
// ============================================================

#if STAGE1_SERIAL_DEBUG
constexpr size_t SERIAL_LINE_SIZE = 320;
char serialLine[SERIAL_LINE_SIZE];
size_t serialLineLength = 0;
bool serialLineOverflow = false;
bool relearnConfirmationPending = false;
uint32_t relearnPendingCommandId = 0UL;
#endif

// ============================================================
// STATUS LED SERVICE
// ============================================================

void statusLedWrite(bool on) {
  statusLedOn = on;
  digitalWrite(pinStatusLed, on ? LOW : HIGH);
}

void statusLedRefreshErrorState() {
  // v1.0: the error LED reflects WiFi liveness only. Storage, MQTT and
  // manual error flags keep their internal state for diagnostics but no
  // longer drive the LED. Deliberate WiFi disable is not an error, so
  // statusLedWifiErrorActive is only ever set by
  // statusLedServiceWifiErrorDelay().
  statusLedErrorActive = statusLedWifiErrorActive;
  if (!statusLedErrorActive && statusLedMode == StatusLedMode::ERROR) {
    statusLedMode = StatusLedMode::OFF;
    statusLedWrite(false);
  }
}

void statusLedInitialize() {
  pinMode(pinStatusLed, OUTPUT);
  statusLedMode = StatusLedMode::OFF;
  statusLedPulsePending = false;
  statusLedErrorActive = false;
  statusLedManualErrorActive = false;
  statusLedStorageErrorActive = false;
  statusLedWifiErrorActive = false;
  statusLedMqttErrorActive = false;
  statusLedNextToggleMs = 0UL;
  statusLedPulseUntilMs = 0UL;
  statusLedWrite(false);
}

void statusLedSetError(bool active) { statusLedManualErrorActive = active; statusLedRefreshErrorState(); }
void statusLedSetStorageError(bool active) { statusLedStorageErrorActive = active; statusLedRefreshErrorState(); }
void statusLedSetWifiError(bool active) { statusLedWifiErrorActive = active; statusLedRefreshErrorState(); }
void statusLedSetMqttError(bool active) { statusLedMqttErrorActive = active; statusLedRefreshErrorState(); }

void statusLedStartLearning() {
  statusLedMode = StatusLedMode::LEARNING;
  statusLedPulsePending = false;
  statusLedNextToggleMs = millis();
  statusLedWrite(false);
}

void statusLedStopLearning() {
  if (statusLedMode == StatusLedMode::LEARNING) statusLedMode = StatusLedMode::OFF;
  statusLedWrite(false);
}

void statusLedPulseTransmit() {
  statusLedMode = StatusLedMode::OFF;
  statusLedPulsePending = true;
  statusLedPulseUntilMs = millis() + STATUS_LED_TX_PULSE_MS;
  statusLedWrite(true);
}

void statusLedServiceLearningWait() {
  if (irState != IrEngineState::LEARNING || statusLedMode != StatusLedMode::LEARNING) return;
  const uint32_t now = millis();
  if (static_cast<int32_t>(now - statusLedNextToggleMs) >= 0) {
    statusLedNextToggleMs = now + STATUS_LED_LEARN_BLINK_MS;
    statusLedWrite(!statusLedOn);
  }
}

void statusLedService() {
  if (irState != IrEngineState::IDLE) return;
  const uint32_t now = millis();
  if (statusLedPulsePending) {
    if (static_cast<int32_t>(now - statusLedPulseUntilMs) >= 0) {
      statusLedPulsePending = false; statusLedWrite(false);
    }
    return;
  }
  if (statusLedErrorActive) {
    if (statusLedMode != StatusLedMode::ERROR) {
      statusLedMode = StatusLedMode::ERROR;
      statusLedNextToggleMs = now;
      statusLedWrite(false);
    }
    if (static_cast<int32_t>(now - statusLedNextToggleMs) >= 0) {
      statusLedNextToggleMs = now + STATUS_LED_ERROR_BLINK_MS;
      statusLedWrite(!statusLedOn);
    }
    return;
  }
  if (statusLedMode == StatusLedMode::ERROR) statusLedMode = StatusLedMode::OFF;
  statusLedWrite(false);
}

// ============================================================
// Delayed WiFi-loss error LED (v1.0)
// ============================================================
// The LED blinks for error only after the WiFi link has been down for
// more than STATUS_LED_WIFI_ERROR_DELAY_MS. Short dropouts and automatic
// reconnects do not trigger it. Deliberate WiFi disable is not an error.
static uint32_t wifiDisconnectStartMs = 0UL;
constexpr uint32_t STATUS_LED_WIFI_ERROR_DELAY_MS = 30000UL;

void statusLedServiceWifiErrorDelay() {
  const bool wifiActive = (wifiConfig.ssid[0] != '\0');
  const bool wifiOnline = (WiFi.status() == WL_CONNECTED);

  if (!wifiActive || wifiOnline) {
    // Either intentionally off, or connected. Clear any pending error.
    wifiDisconnectStartMs = 0UL;
    if (statusLedWifiErrorActive) {
      statusLedWifiErrorActive = false;
      statusLedRefreshErrorState();
    }
    return;
  }

  // WiFi enabled and configured, but not connected.
  const uint32_t now = millis();
  if (wifiDisconnectStartMs == 0UL) {
    // First tick of a fresh disconnect — start the timer, LED stays off.
    wifiDisconnectStartMs = now;
    return;
  }

  const bool shouldBlink = (now - wifiDisconnectStartMs) >= STATUS_LED_WIFI_ERROR_DELAY_MS;
  if (shouldBlink != statusLedWifiErrorActive) {
    statusLedWifiErrorActive = shouldBlink;
    statusLedRefreshErrorState();
  }
}

void statusLedPrintStatus() {
#if STAGE1_SERIAL_DEBUG
  if (!serialEnabled) return;
  Serial.println();
  Serial.println(F("=== STATUS LED ==="));
  Serial.println(F("Type          : Single LED / active LOW"));
  Serial.print(F("GPIO          : GPIO")); Serial.println(pinStatusLed);
  Serial.println(F("Idle          : OFF"));
  Serial.println(F("Transmit      : one brief blink after TX"));
  Serial.println(F("Learning      : continuous blink while waiting"));
  Serial.println(F("Error         : slow blink"));
  Serial.print(F("Error active  : ")); Serial.println(statusLedErrorActive ? F("YES") : F("NO"));
  Serial.print(F("Manual error  : ")); Serial.println(statusLedManualErrorActive ? F("YES") : F("NO"));
  Serial.print(F("Storage error : ")); Serial.println(statusLedStorageErrorActive ? F("YES") : F("NO"));
  Serial.print(F("Wi-Fi error   : ")); Serial.println(statusLedWifiErrorActive ? F("YES") : F("NO"));
  Serial.println(F("=================="));
  Serial.println();
#endif
}

// ============================================================
// UTILITY
// ============================================================

void feedWatchdog() { ESP.wdtFeed(); yield(); }

void rebootDevice() {
  if (serialEnabled) {
    Serial.println(F("Rebooting ESP8266..."));
    Serial.flush();
  }
  delay(100);
  ESP.restart();
}

void serviceSystemBackgroundOnly() {
  ESP.wdtFeed();
  yield();
  statusLedServiceLearningWait();
}

uint32_t crc32Buffer(const uint16_t *data, uint16_t length) {
  uint32_t crc = 0xFFFFFFFFUL;
  for (uint16_t i = 0; i < length; i++) {
    uint16_t value = data[i];
    for (uint8_t byteIndex = 0; byteIndex < 2; byteIndex++) {
      uint8_t byteValue = static_cast<uint8_t>(value & 0xFFU);
      value >>= 8;
      crc ^= byteValue;
      for (uint8_t bit = 0; bit < 8; bit++) {
        const uint32_t mask = 0UL - (crc & 1UL);
        crc = (crc >> 1) ^ (0xEDB88320UL & mask);
      }
    }
  }
  return ~crc;
}

bool storedSignalIntegrityOK() {
  if (lastRawLen == 0 || lastRawLen > RAW_WAVEFORM_CAPACITY) return false;
  return crc32Buffer(lastRaw, lastRawLen) == lastRawCrc32;
}

uint32_t calculateWaveformDurationUs(const uint16_t *data, uint16_t length) {
  uint32_t total = 0;
  for (uint16_t i = 0; i < length; i++) {
    if (UINT32_MAX - total < static_cast<uint32_t>(data[i])) return UINT32_MAX;
    total += static_cast<uint32_t>(data[i]);
  }
  return total;
}

bool hasLearnedSignal() {
  return lastRawLen > 0 && lastRawLen <= RAW_WAVEFORM_CAPACITY && storedSignalIntegrityOK();
}

void clearCurrentCommandRuntimeMetadata();
void clearLastCapture() {
  lastRawLen = 0;
  lastRawCrc32 = 0;
  lastLearnMetadataValid = false;
  clearCurrentCommandRuntimeMetadata();
}

void updateMinimumHeap() {
#if STAGE1_SERIAL_DEBUG
  const uint32_t heap = ESP.getFreeHeap();
  if (heap < minFreeHeap) minFreeHeap = heap;
#endif
}

// ============================================================
// IR RECEIVER CONTROL
// ============================================================

void startIRReceiver() {
  if (!irReceiverActive && irrecvPtr != nullptr) {
    irrecvPtr->enableIRIn();
    irReceiverActive = true;
  }
}
void stopIRReceiver() {
  if (irReceiverActive && irrecvPtr != nullptr) {
    irrecvPtr->disableIRIn();
    irReceiverActive = false;
  }
}

// ============================================================
// SAFE GPIO INITIALIZATION
// ============================================================

void initializeHardwarePins() {
  pinMode(pinIrTx, OUTPUT);
  digitalWrite(pinIrTx, LOW);
  pinMode(pinIrRx, INPUT);
  pinMode(pinDs18b20, INPUT);
  pinMode(PIN_FLASH_CS, OUTPUT);
  digitalWrite(PIN_FLASH_CS, HIGH);
  SPI.begin();
  pinMode(PIN_FLASH_CS, OUTPUT);
  digitalWrite(PIN_FLASH_CS, HIGH);
  statusLedInitialize();
}

void hardwareSelfTest() {
#if STAGE1_SERIAL_DEBUG
  if (!serialEnabled) return;
  Serial.println();
  Serial.println(F("--- HARDWARE FOUNDATION SELF-TEST ---"));
  Serial.println(F("Learn button      : DISABLED; GPIO0 reserved for boot strap"));
  Serial.print(F("IR TX default LOW : ")); Serial.println((digitalRead(pinIrTx) == LOW) ? F("PASS") : F("FAIL"));
  Serial.print(F("W25Qxx CS idle HIGH: ")); Serial.println((digitalRead(PIN_FLASH_CS) == HIGH) ? F("PASS") : F("FAIL"));
  Serial.print(F("DS18B20 GPIO       : GPIO")); Serial.println(pinDs18b20);
  Serial.print(F("IR RX GPIO         : GPIO")); Serial.println(pinIrRx);
  Serial.print(F("IR TX GPIO         : GPIO")); Serial.println(pinIrTx);
  Serial.print(F("Status LED GPIO    : GPIO")); Serial.println(pinStatusLed);
  Serial.println(F("SPI pins           : GPIO14 SCLK / GPIO12 MISO / GPIO13 MOSI"));
  Serial.println(F("W25Qxx access      : persistent storage"));
  Serial.println(F("IR receiver idle   : DISABLED"));
  Serial.println(F("--------------------------------------"));
  Serial.println();
#endif
}

// ============================================================
// CAPTURE VALIDATION
// ============================================================

bool calculateConvertedRawLength(const decode_results &capture, uint16_t destinationCapacity, uint16_t &requiredLength) {
  requiredLength = 0;
  if (capture.rawbuf == nullptr) return false;
  if (capture.rawlen < 2 || capture.rawlen > IRRECV_BUFFER_SIZE) return false;
  uint32_t required = 0;
  for (uint16_t i = 1; i < capture.rawlen; i++) {
    const uint32_t usecs = static_cast<uint32_t>(capture.rawbuf[i]) * kRawTick;
    if (usecs == 0) return false;
    if (usecs > UINT16_MAX) {
      const uint32_t chunks = static_cast<uint32_t>((usecs + static_cast<uint32_t>(UINT16_MAX) - 1UL) / static_cast<uint32_t>(UINT16_MAX));
      required += static_cast<uint32_t>((chunks * 2UL) - 1UL);
    } else required += 1UL;
    if (required > destinationCapacity) return false;
  }
  requiredLength = static_cast<uint16_t>(required);
  return requiredLength > 0;
}

bool validateCapture(const decode_results &capture) {
  if (capture.overflow) { DBG_PRINTLN(F("ERROR: capture overflow.")); return false; }
  if (capture.rawlen < 2) { DBG_PRINTLN(F("ERROR: raw capture is too short.")); return false; }
  if (capture.rawlen > IRRECV_BUFFER_SIZE) { DBG_PRINTLN(F("ERROR: raw capture exceeds receiver buffer size.")); return false; }
  uint16_t requiredLength = 0;
  if (!calculateConvertedRawLength(capture, RAW_WAVEFORM_CAPACITY, requiredLength)) {
    DBG_PRINTLN(F("ERROR: raw capture cannot fit converted buffer.")); return false;
  }
  return true;
}

// ============================================================
// FIXED-BUFFER RAW CONVERSION
// ============================================================

bool convertCaptureToRaw(const decode_results &capture, uint16_t *destination, uint16_t destinationCapacity, uint16_t &outputLength) {
  outputLength = 0;
  uint16_t requiredLength = 0;
  if (!calculateConvertedRawLength(capture, destinationCapacity, requiredLength)) return false;
  uint16_t pos = 0;
  for (uint16_t i = 1; i < capture.rawlen; i++) {
    uint32_t usecs = static_cast<uint32_t>(capture.rawbuf[i]) * kRawTick;
    while (usecs > UINT16_MAX) {
      if (static_cast<uint32_t>(pos) + 2UL > destinationCapacity) { outputLength = 0; return false; }
      destination[pos++] = UINT16_MAX;
      destination[pos++] = 0;
      usecs -= UINT16_MAX;
    }
    if (pos >= destinationCapacity || usecs == 0) { outputLength = 0; return false; }
    destination[pos++] = static_cast<uint16_t>(usecs);
  }
  if (pos != requiredLength || pos == 0) { outputLength = 0; return false; }
  outputLength = pos;
  return true;
}

// ============================================================
// STORE CAPTURE
// ============================================================

bool storeCapture(const decode_results &capture) {
  if (capture.overflow) return false;
  // storageRecordBuffer is idle while an IR learn is in progress; use it
  // as scratch. The buffer is alignas(4), so the uint16_t* cast is safe.
  uint16_t *scratch = reinterpret_cast<uint16_t *>(storageRecordBuffer);
  uint16_t newLength = 0;
  if (!convertCaptureToRaw(capture, scratch, RAW_WAVEFORM_CAPACITY, newLength)) return false;
  const uint32_t newCrc32 = crc32Buffer(scratch, newLength);
  memcpy(lastRaw, scratch, static_cast<size_t>(newLength) * sizeof(uint16_t));
  lastRawLen = newLength;
  lastRawCrc32 = newCrc32;
  if (newLength > irStats.maxStoredRawLen) irStats.maxStoredRawLen = newLength;
  const uint32_t duration = calculateWaveformDurationUs(lastRaw, lastRawLen);
  if (duration > irStats.maxWaveformDurationUs && duration != UINT32_MAX) irStats.maxWaveformDurationUs = duration;
  updateMinimumHeap();
  return storedSignalIntegrityOK();
}

void printCaptureInfo(const decode_results &capture) {
#if STAGE1_SERIAL_DEBUG
  if (!serialEnabled) { (void)capture; return; }
  Serial.println();
  Serial.println(F("========================================"));
  Serial.println(F("IR CAPTURE"));
  Serial.println(F("========================================"));
  Serial.print(F("Protocol : ")); Serial.println(typeToString(capture.decode_type));
  Serial.print(F("Repeat   : ")); Serial.println(capture.repeat ? F("YES") : F("NO"));
  Serial.print(F("Bits     : ")); Serial.println(capture.bits);
  Serial.print(F("Raw len  : ")); Serial.println(capture.rawlen);
  Serial.print(F("Overflow : ")); Serial.println(capture.overflow ? F("YES") : F("NO"));
  Serial.print(F("Code     : ")); Serial.println(resultToHexidecimal(&capture));
  uint16_t convertedLength = 0;
  if (calculateConvertedRawLength(capture, RAW_WAVEFORM_CAPACITY, convertedLength)) {
    Serial.print(F("Converted length : ")); Serial.println(convertedLength);
  } else Serial.println(F("Converted length : INVALID"));
  Serial.print(F("Free heap         : ")); Serial.println(ESP.getFreeHeap());
  Serial.println(F("========================================"));
  Serial.println();
#else
  (void)capture;
#endif
}

void printStoredRaw() {
#if STAGE1_SERIAL_DEBUG
  if (!serialEnabled) return;
  if (!hasLearnedSignal()) { Serial.println(F("No learned signal is stored.")); return; }
  if (irState != IrEngineState::IDLE) { Serial.println(F("ERROR: IR engine is busy.")); return; }
  Serial.println();
  Serial.println(F("========================================"));
  Serial.println(F("STORED RAW DATA"));
  Serial.println(F("========================================"));
  Serial.print(F("Length: ")); Serial.println(lastRawLen);
  Serial.print(F("CRC32 : 0x")); Serial.println(lastRawCrc32, HEX);
  for (uint16_t i = 0; i < lastRawLen; i++) {
    if ((i % 8) == 0) { Serial.println(); Serial.print(F("  ")); }
    Serial.print(lastRaw[i]);
    if (i < lastRawLen - 1) Serial.print(F(", "));
    if ((i % 32) == 31) feedWatchdog();
  }
  Serial.println();
  Serial.println(F("========================================"));
  Serial.println();
#endif
}

// ============================================================
// WATCHDOG-SAFE RAW TRANSMISSION
// ============================================================

void sendStoredRawFrame() {
  if (irsendPtr == nullptr) return;
  irsendPtr->enableIROut(txFrequencyHz);
  for (uint16_t i = 0; i < lastRawLen; i++) {
    if (i & 1U) irsendPtr->space(lastRaw[i]);
    else irsendPtr->mark(lastRaw[i]);
    if ((i + 1U) % TX_WDT_FEED_INTERVAL == 0) ESP.wdtFeed();
  }
  irsendPtr->space(0);
}

#if STAGE1_SERIAL_DEBUG
void discardSerialInputDuringCriticalTask() {
  if (!serialEnabled) return;
  while (Serial.available()) (void)Serial.read();
  serialLineLength = 0;
  serialLineOverflow = false;
}
#endif

void resynchronizeLearnButtonAfterCriticalTask() {}

// ============================================================
// TRANSMIT RAW CAPTURE
// ============================================================

constexpr uint16_t CHANNEL_MARK_HZ  = MIN_TX_FREQUENCY_HZ;   // marks a "channel" command record
constexpr uint16_t CHANNEL_MARK_GAP = 65535U;
bool irChannelTryTransmit(bool &handledOut);
bool transmitLastCapture() {
  { bool handled = false; const bool queued = irChannelTryTransmit(handled); if (handled) return queued; }
  if (irState != IrEngineState::IDLE) { DBG_PRINTLN(F("ERROR: IR engine is busy.")); irStats.transmissionRejected++; return false; }
  if (irsendPtr == nullptr) { DBG_PRINTLN(F("ERROR: IR transmitter not initialized.")); irStats.transmissionRejected++; return false; }
  if (!hasLearnedSignal()) { DBG_PRINTLN(F("ERROR: stored waveform integrity check failed or no signal is stored.")); irStats.transmissionRejected++; return false; }
  if (txRepeatCount == 0) { DBG_PRINTLN(F("ERROR: repeat count must be at least 1.")); irStats.transmissionRejected++; return false; }
  if (txFrequencyHz < MIN_TX_FREQUENCY_HZ || txFrequencyHz > MAX_TX_FREQUENCY_HZ) {
    DBG_PRINTLN(F("ERROR: TX frequency is outside Stage 1 limits.")); irStats.transmissionRejected++; return false;
  }
  irState = IrEngineState::TRANSMITTING;
  irStats.transmissionsStarted++;
#if STAGE1_SERIAL_DEBUG
  discardSerialInputDuringCriticalTask();
#endif
  DBG_PRINTLN_EMPTY();
  DBG_PRINTLN(F("========================================"));
  DBG_PRINTLN(F("IR TRANSMISSION"));
  DBG_PRINT(F("Raw length : ")); DBG_PRINTLN(lastRawLen);
  DBG_PRINT(F("Frequency  : ")); DBG_PRINT(txFrequencyHz); DBG_PRINTLN(F(" Hz"));
  DBG_PRINT(F("Repeats    : ")); DBG_PRINTLN(txRepeatCount);
  DBG_PRINT(F("Gap        : ")); DBG_PRINT(txRepeatGapMs); DBG_PRINTLN(F(" ms"));
  stopIRReceiver();
  digitalWrite(pinIrTx, LOW);
  delay(2);
  for (uint16_t i = 0; i < txRepeatCount; i++) {
    sendStoredRawFrame();
    ESP.wdtFeed();
    if (i + 1U < txRepeatCount) delay(txRepeatGapMs);
  }
  digitalWrite(pinIrTx, LOW);
  delay(5);
  irState = IrEngineState::IDLE;
  irStats.transmissionsCompleted++;
#if STAGE1_SERIAL_DEBUG
  discardSerialInputDuringCriticalTask();
#endif
  resynchronizeLearnButtonAfterCriticalTask();
  updateMinimumHeap();
  DBG_PRINTLN(F("Transmission complete."));
  DBG_PRINTLN(F("========================================"));
  DBG_PRINTLN_EMPTY();
  return true;
}

// ============================================================
// LEARN ONE SIGNAL
// ============================================================

bool learnSignal() {
  if (irState != IrEngineState::IDLE) { DBG_PRINTLN(F("ERROR: IR engine is busy.")); return false; }
  if (irrecvPtr == nullptr) { DBG_PRINTLN(F("ERROR: IR receiver not initialized.")); return false; }
  irState = IrEngineState::LEARNING;
  irStats.learnAttempts++;
#if STAGE1_SERIAL_DEBUG
  discardSerialInputDuringCriticalTask();
#endif
  DBG_PRINTLN_EMPTY();
  DBG_PRINTLN(F("========================================"));
  DBG_PRINTLN(F("LEARN MODE"));
  DBG_PRINTLN(F("========================================"));
  DBG_PRINTLN(F("Point the remote at the IR receiver."));
  DBG_PRINTLN(F("Press the desired remote button ONCE."));
  DBG_PRINTLN(F("15 second Learn-session timeout."));
  DBG_PRINTLN_EMPTY();
  digitalWrite(pinIrTx, LOW);
  stopIRReceiver();
  startIRReceiver();
  const uint32_t learnStart = millis();
#if STAGE1_SERIAL_DEBUG
  uint32_t lastStatus = learnStart;
#endif
  while ((millis() - learnStart) < LEARN_SESSION_TIMEOUT_MS) {
    serviceSystemBackgroundOnly();
    if (irrecvPtr->decode(&results)) {
      stopIRReceiver();
      if (results.rawlen > irStats.maxCapturedRawLen) irStats.maxCapturedRawLen = results.rawlen;
      DBG_PRINTLN(F("Signal captured."));
      printCaptureInfo(results);
      if (!validateCapture(results)) {
        if (results.overflow) irStats.learnOverflows++; else irStats.malformedCaptures++;
        DBG_PRINTLN(F("Capture rejected; continuing to wait."));
        startIRReceiver();
      } else if (!storeCapture(results)) {
        irStats.storeFailures++;
        DBG_PRINTLN(F("ERROR: captured waveform could not be stored."));
        DBG_PRINTLN(F("Previous learned signal was preserved."));
        startIRReceiver();
      } else {
        lastLearnCarrierHz = txFrequencyHz;
        lastLearnRepeatCount = txRepeatCount;
        lastLearnRepeatGapMs = txRepeatGapMs;
        lastLearnMetadataValid = true;
        irStats.successfulLearns++;
        DBG_PRINT(F("Raw waveform saved: ")); DBG_PRINT(lastRawLen); DBG_PRINTLN(F(" timings."));
        DBG_PRINT(F("Learn TX profile: ")); DBG_PRINT(lastLearnCarrierHz);
        DBG_PRINT(F(" Hz / repeat ")); DBG_PRINT(lastLearnRepeatCount);
        DBG_PRINT(F(" / gap ")); DBG_PRINT(lastLearnRepeatGapMs);
        DBG_PRINTLN(F(" ms"));
        irState = IrEngineState::IDLE;
#if STAGE1_SERIAL_DEBUG
        discardSerialInputDuringCriticalTask();
#endif
        resynchronizeLearnButtonAfterCriticalTask();
        updateMinimumHeap();
        DBG_PRINTLN(F("Learning successful."));
        DBG_PRINTLN(F("Use T to transmit/test the learned signal."));
        DBG_PRINTLN(F("========================================"));
        DBG_PRINTLN_EMPTY();
        return true;
      }
    }
#if STAGE1_SERIAL_DEBUG
    if (serialEnabled && (millis() - lastStatus) >= 1000UL) {
      const uint32_t now = millis();
      lastStatus = now;
      const uint32_t elapsed = now - learnStart;
      const uint32_t remaining = (elapsed < LEARN_SESSION_TIMEOUT_MS) ? (LEARN_SESSION_TIMEOUT_MS - elapsed) : 0;
      DBG_PRINT(F("Learning... ")); DBG_PRINT(remaining / 1000UL); DBG_PRINTLN(F(" s remaining"));
    }
#endif
  }
  stopIRReceiver();
  irState = IrEngineState::IDLE;
  irStats.learnTimeouts++;
#if STAGE1_SERIAL_DEBUG
  discardSerialInputDuringCriticalTask();
#endif
  resynchronizeLearnButtonAfterCriticalTask();
  updateMinimumHeap();
  DBG_PRINTLN(F("Learning timed out."));
  DBG_PRINTLN(F("No valid IR command was stored."));
  DBG_PRINTLN(F("Previous learned signal was preserved."));
  DBG_PRINTLN(F("========================================"));
  DBG_PRINTLN_EMPTY();
  return false;
}

// ============================================================
// W25Qxx PERSISTENT STORAGE ENGINE
// ============================================================

constexpr uint32_t FLASH_MANUFACTURER_WINBOND = 0xEFUL;
constexpr uint8_t FLASH_MEMORY_TYPE_WINBOND_SERIAL_NOR = 0x40;
constexpr uint8_t FLASH_CAPACITY_W25Qxx = 0x16;
constexpr uint8_t FLASH_CAPACITY_W25Q64 = 0x17;

constexpr uint32_t STORAGE_FLASH_SECTOR_SIZE = 4096UL;
constexpr uint16_t STORAGE_FLASH_PAGE_SIZE = 256;
constexpr uint32_t DB_MAGIC = 0x49524842UL;
constexpr uint32_t RECORD_MAGIC = 0x49524352UL;
constexpr uint32_t COMMIT_MAGIC = 0xC0DE17EDUL;
constexpr uint16_t STORAGE_FORMAT_VERSION = 1;
constexpr uint16_t RECORD_FORMAT_VERSION = 1;
constexpr uint8_t RECORD_TYPE_DEVICE = 1;
constexpr uint8_t RECORD_TYPE_COMMAND = 2;
constexpr uint8_t RECORD_TYPE_DELETE_DEVICE = 3;
constexpr uint8_t RECORD_TYPE_DELETE_COMMAND = 4;
constexpr uint8_t RECORD_TYPE_RULE = 5;
constexpr uint8_t RECORD_TYPE_DELETE_RULE = 6;
constexpr uint8_t RECORD_TYPE_SCHEDULE = 7;
constexpr uint8_t RECORD_TYPE_DELETE_SCHEDULE = 8;
constexpr uint8_t RECORD_TYPE_ORDER = 9;
constexpr uint8_t RECORD_TYPE_CONFIG_BACKUP = 10;
constexpr uint8_t RECORD_TYPE_DEVICE_SETTINGS  = 11;
constexpr uint8_t RECORD_TYPE_COMMAND_SETTINGS = 12;

// Must match CONFIG_EEPROM_SIZE in webui_backend.h. The static_assert
// near that definition guarantees the two stay in sync at compile time.
constexpr uint16_t STORAGE_CONFIG_BACKUP_PAYLOAD_BYTES = 1264U;
// Must match sizeof(StoredRule) in the automation module.
constexpr uint16_t RULE_PAYLOAD_BYTES_V1 = 84U;    // legacy single-action blocks
constexpr uint16_t RULE_PAYLOAD_BYTES    = 292U;   // v2 compound rules
constexpr uint16_t SCHEDULE_PAYLOAD_BYTES = 12U;
constexpr uint8_t RECORD_FLAG_COMMITTED = 0x01U;
constexpr uint32_t DB_PRIMARY_SECTOR = 0;
constexpr uint32_t DB_BACKUP_SECTOR = 1;
constexpr uint32_t DB_DATA_START_SECTOR = 2;
constexpr uint8_t STORAGE_SPI_MHZ = 8;
constexpr size_t STORAGE_MAX_NAME = 31;
constexpr uint32_t STORAGE_HEADER_BYTES = 32UL;
constexpr uint32_t STORAGE_COMMIT_OFFSET = STORAGE_FLASH_SECTOR_SIZE - 4UL;

constexpr uint32_t FORMAT_INTENT_MAGIC = 0x46524D54UL;
constexpr uint16_t FORMAT_INTENT_VERSION = 1;
constexpr uint32_t FORMAT_INTENT_SLOT_SIZE = 32UL;

#pragma pack(push, 1)
struct DatabaseHeader {
  uint32_t magic;
  uint16_t formatVersion;
  uint16_t headerSize;
  uint32_t flashSizeBytes;
  uint32_t dataStartSector;
  uint32_t generation;
  uint32_t headerCrc32;
  uint32_t reserved;
  uint32_t commit;
};
struct StorageRecordHeader {
  uint32_t magic;
  uint16_t formatVersion;
  uint8_t type;
  uint8_t flags;
  uint32_t generation;
  uint32_t sequence;
  uint32_t recordId;
  uint32_t deviceId;
  uint16_t nameLength;
  uint16_t rawLength;
  uint16_t carrierHz;
  uint8_t repeatCount;
  uint8_t reserved0;
  uint16_t repeatGapMs;
  uint16_t payloadLength;
  uint32_t headerCrc32;
  uint32_t payloadCrc32;
};
#pragma pack(pop)

#pragma pack(push, 1)
struct FormatIntent {
  uint32_t magic;
  uint16_t version;
  uint16_t reserved;
  uint32_t generation;
  uint32_t crc32;
  uint32_t commit;
};
#pragma pack(pop)

constexpr uint32_t FORMAT_INTENT_OFFSET = sizeof(DatabaseHeader);
constexpr uint32_t FORMAT_INTENT_SLOT_COUNT = (STORAGE_FLASH_SECTOR_SIZE - FORMAT_INTENT_OFFSET) / FORMAT_INTENT_SLOT_SIZE;
static_assert(sizeof(FormatIntent) == 20, "FormatIntent size must remain 20 bytes");
static_assert(FORMAT_INTENT_SLOT_SIZE >= sizeof(FormatIntent), "FormatIntent slot must fit the intent record");
static_assert(FORMAT_INTENT_SLOT_COUNT > 1, "FormatIntent journal needs multiple slots");
static_assert(FORMAT_INTENT_OFFSET + FORMAT_INTENT_SLOT_COUNT * FORMAT_INTENT_SLOT_SIZE <= STORAGE_FLASH_SECTOR_SIZE, "FormatIntent journal must fit in metadata sector");
static_assert(sizeof(DatabaseHeader) == STORAGE_HEADER_BYTES, "DatabaseHeader size must remain 32 bytes");
static_assert(sizeof(StorageRecordHeader) == 44, "StorageRecordHeader size must remain 44 bytes");

enum class StableReadResult : uint8_t { VALID, INVALID, UNCERTAIN };
enum class PayloadVerifyResult : uint8_t { VALID, CORRUPT, UNCERTAIN };
enum class FormatIntentFindResult : uint8_t { NONE, FOUND, UNCERTAIN };

StableReadResult storageReadDatabaseHeaderStable(uint32_t sector, DatabaseHeader &header);
bool flashReadDatabaseHeaderWithoutCommit(uint32_t sector, DatabaseHeader &header);
bool flashReadBytes(uint32_t address, uint8_t *buffer, uint16_t length);

bool flashReadSmallConfirmed(uint32_t address, uint8_t *buffer, uint16_t length) {
  if (buffer == nullptr || length == 0 || length > STORAGE_MAX_NAME) return false;
  uint8_t second[STORAGE_MAX_NAME + 1] = {0};
  uint8_t third[STORAGE_MAX_NAME + 1] = {0};
  for (uint8_t attempt = 0; attempt < 3; ++attempt) {
    if (!flashReadBytes(address, buffer, length) ||
        !flashReadBytes(address, second, length) ||
        !flashReadBytes(address, third, length) ||
        memcmp(buffer, second, length) != 0 ||
        memcmp(buffer, third, length) != 0) {
      delay(1);
      continue;
    }
    return true;
  }
  return false;
}

bool storageReadRecordHeaderStable(uint32_t sector, StorageRecordHeader &header);
bool storageReadCommitStable(uint32_t sector, uint32_t &commit);
PayloadVerifyResult storageReadPayloadStable(uint32_t sector, const StorageRecordHeader &header);
bool storageReadPayloadVerifiedIntoBuffer(uint32_t sector, const StorageRecordHeader &header);
bool storageValidateRecordHeaderForBody(const StorageRecordHeader *header, uint32_t generation);
void storageQuarantineAppendSector(uint32_t sector, const StorageRecordHeader &header);
void storageQuarantineSector(uint32_t sector);
void storageResetDeviceIndex();
void storageRegisterDeviceIndex(uint32_t deviceId, uint32_t sector, uint16_t nameCrc, uint32_t sequence);
bool storageRecoverDeviceIndexEntry(uint32_t deviceId);
bool storageHasIndexedValidDeviceId(uint32_t deviceId);
DeviceLookupResult storageFindDeviceByNamePersistent(const char *name, uint16_t nameCrc, size_t nameLength, uint32_t &deviceIdOut);
bool storageDeviceIdIsUniquePersistent(uint32_t deviceId, uint32_t canonicalSector);
uint32_t storageMaxPhysicalIdentity();
bool storageIsDeviceIdentityConflicted(uint32_t deviceId);
bool storageIsCommandIdentityConflicted(uint32_t commandId);
bool storageWasDeviceIdentitySeen(uint32_t deviceId);
bool storageWasCommandIdentitySeen(uint32_t commandId);
void storageMarkDeviceIdentitySeen(uint32_t deviceId);
void storageMarkDeviceIdentityConflicted(uint32_t deviceId);
void storageMarkCommandIdentitySeen(uint32_t commandId);
void storageMarkCommandIdentityConflicted(uint32_t commandId);
void storageRemoveDeviceIndexEntries(uint32_t deviceId);
bool storageIsDeviceDeleted(uint32_t deviceId);
bool storageIsCommandDeleted(uint32_t commandId);
bool storageAppendDeleteRecord(uint8_t deleteType, uint32_t targetId, uint32_t targetDeviceId, uint32_t &sectorOut, uint32_t &sequenceOut);
bool storageDeleteDevice(uint32_t deviceId);
bool storageDeleteCommand(uint32_t commandId);
bool storageRelearnCommand(uint32_t commandId);
bool storageRenameDevice(uint32_t deviceId, const char *newName);
bool storageRenameCommand(uint32_t commandId, const char *newName);
bool storageResetDatabaseTargeted();
FormatIntentFindResult storageFindFormatIntent(uint32_t &sectorOut, uint32_t &generationOut);
bool storageDataAreaHeadersBlank();
bool storageWipeDatabase();
bool storageJobIsRunning();
bool storageJobStartReset();
bool storageJobStartWipe();
void storageJobService();
uint8_t storageJobGetPercent();
void storageJobFail(const char *reason);
void storageJobFail(const char *reason);
void storageJobFail(const char *reason);
void storageJobFail(const char *reason);

enum class StorageJobKind : uint8_t { NONE, RESET, WIPE };
enum class StorageJobState : uint8_t { IDLE, RUNNING, DONE, FAILED };

struct StorageJobRuntime {
  StorageJobKind  kind       = StorageJobKind::NONE;
  StorageJobState state      = StorageJobState::IDLE;  uint8_t         phase      = 0;
  uint32_t        cursor     = 0;
  uint32_t        total      = 0;
  uint32_t        processed  = 0;
  uint32_t        failed     = 0;
  uint32_t        newGen     = 0;
  uint32_t        hdrPrimary = DB_PRIMARY_SECTOR;
  uint32_t        hdrBackup  = DB_BACKUP_SECTOR;
  uint32_t        startedMs  = 0;
  uint32_t        finishedMs = 0;
  char            message[80] = {0};
};
static StorageJobRuntime storageJob;
bool commandEqualsIgnoreCase(const char *a, const char *b);
bool commandStartsWithIgnoreCase(const char *text, const char *prefix);

SPISettings flashSpiSettings(1000000UL * STORAGE_SPI_MHZ, MSBFIRST, SPI_MODE0);

struct StorageState {
  bool detected = false;
  bool initialized = false;
  bool headerCorrupt = false;
  uint32_t flashSizeBytes = 0;
  uint32_t sectorCount = 0;
  uint8_t manufacturer = 0;
  uint8_t memoryType = 0;
  uint8_t capacityCode = 0;
  uint32_t generation = 0;
  uint32_t maxSequence = 0;
  uint32_t maxCommandId = 0;
  uint32_t maxDeviceId = 0;
  uint32_t validRecordCount = 0;
  uint32_t corruptRecordCount = 0;
  uint32_t obsoleteRecordCount = 0;
  uint32_t usedSectorCount = 0;
  uint32_t freeSectorCount = 0;
  uint32_t firstFreeSector = UINT32_MAX;
  bool freeSpaceIndexValid = false;
  uint32_t latestCommandSector = UINT32_MAX;
  uint32_t latestCommandId = 0;
  uint32_t latestCommandDeviceId = 0;
  uint32_t currentDeviceId = 0;
  char currentDeviceName[STORAGE_MAX_NAME + 1] = {0};
  uint32_t currentCommandId = 0;
  char currentCommandName[STORAGE_MAX_NAME + 1] = {0};
};
StorageState storage;

void clearCurrentCommandRuntimeMetadata() {
  storage.currentCommandId = 0;
  storage.currentCommandName[0] = '\0';
}

constexpr size_t STORAGE_MAX_PAYLOAD_LENGTH = STORAGE_MAX_NAME + (RAW_WAVEFORM_CAPACITY * sizeof(uint16_t));
constexpr size_t STORAGE_RECORD_BUFFER_SIZE = sizeof(StorageRecordHeader) + STORAGE_MAX_PAYLOAD_LENGTH;
static_assert(STORAGE_RECORD_BUFFER_SIZE <= STORAGE_FLASH_SECTOR_SIZE - 4UL, "record buffer must fit inside a data sector");
static_assert(STORAGE_RECORD_BUFFER_SIZE == SHARED_RECORD_BUFFER_BYTES,
              "shared staging buffer size must match the storage record layout");
// storageRecordBuffer itself is defined near the top of the file so the
// IR capture path can also use it as scratch.

constexpr uint32_t STORAGE_MAX_SECTORS = 2048UL;
constexpr size_t STORAGE_QUARANTINE_BITMAP_BYTES = (STORAGE_MAX_SECTORS + 7UL) / 8UL;

static uint8_t storageSeenDeviceIdBitmap[STORAGE_QUARANTINE_BITMAP_BYTES] = {0};
static uint8_t storageDeviceIdConflictBitmap[STORAGE_QUARANTINE_BITMAP_BYTES] = {0};
static uint8_t storageSeenCommandIdBitmap[STORAGE_QUARANTINE_BITMAP_BYTES] = {0};
static uint8_t storageCommandIdConflictBitmap[STORAGE_QUARANTINE_BITMAP_BYTES] = {0};
static uint8_t storageDeletedDeviceBitmap[STORAGE_QUARANTINE_BITMAP_BYTES] = {0};
static uint8_t storageDeletedCommandBitmap[STORAGE_QUARANTINE_BITMAP_BYTES] = {0};
static uint8_t storageQuarantineBitmap[STORAGE_QUARANTINE_BITMAP_BYTES] = {0};

// ── v1.0: RAM caches for per-entity settings ─────────────────
// Populated in storageScanDatabase(); updated by the setters.
// Cleared by storageResetScanState()/storageResetRuntimeDatabaseState().
static uint8_t storageCommandAlexaBitmap[STORAGE_QUARANTINE_BITMAP_BYTES] = {0};
static uint8_t storageDeviceCloudMap[256] = {0};   // bit7=cloud, bits[3:0]=category

constexpr uint16_t STORAGE_DEVICE_CACHE_SIZE = 256;
struct DeviceIndexEntry {
  uint16_t id;
  uint16_t sequence;
  uint16_t sector;
  uint16_t nameCrc;
};
static_assert(sizeof(DeviceIndexEntry) == 8, "unexpected DeviceIndexEntry padding");
static DeviceIndexEntry storageDeviceIndex[STORAGE_DEVICE_CACHE_SIZE] = {};
static uint16_t storageDeviceIndexCount = 0;
static uint16_t storageDeviceIndexReplaceCursor = 0;

uint32_t crc32Bytes(const uint8_t *data, size_t length) {
  uint32_t crc = 0xFFFFFFFFUL;
  for (size_t i = 0; i < length; ++i) {
    crc ^= data[i];
    for (uint8_t bit = 0; bit < 8; ++bit) {
      const uint32_t mask = 0UL - (crc & 1UL);
      crc = (crc >> 1) ^ (0xEDB88320UL & mask);
    }
  }
  return ~crc;
}

void storageCS(bool high) { digitalWrite(PIN_FLASH_CS, high ? HIGH : LOW); }

bool flashReadBytes(uint32_t address, uint8_t *buffer, uint16_t length) {
  if (!storage.detected || length == 0 || address >= storage.flashSizeBytes ||
      static_cast<uint64_t>(address) + length > storage.flashSizeBytes) return false;
  SPI.beginTransaction(flashSpiSettings);
  storageCS(false);
  SPI.transfer(0x03);
  SPI.transfer(static_cast<uint8_t>(address >> 16));
  SPI.transfer(static_cast<uint8_t>(address >> 8));
  SPI.transfer(static_cast<uint8_t>(address));
  for (uint16_t i = 0; i < length; ++i) buffer[i] = SPI.transfer(0x00);
  storageCS(true);
  SPI.endTransaction();
  return true;
}

uint8_t flashReadStatus1() {
  SPI.beginTransaction(flashSpiSettings);
  storageCS(false);
  SPI.transfer(0x05);
  const uint8_t value = SPI.transfer(0x00);
  storageCS(true);
  SPI.endTransaction();
  return value;
}

bool flashWaitReady(uint32_t timeoutMs) {
  const uint32_t start = millis();
  while (flashReadStatus1() & 0x01U) {
    yield();
    if ((uint32_t)(millis() - start) >= timeoutMs) return false;
  }
  return true;
}

bool flashWriteEnable() {
  SPI.beginTransaction(flashSpiSettings);
  storageCS(false);
  SPI.transfer(0x06);
  storageCS(true);
  SPI.endTransaction();
  return (flashReadStatus1() & 0x02U) != 0;
}

bool flashProgramPage(uint32_t address, const uint8_t *data, uint16_t length) {
  if (!storage.detected || length == 0 || length > STORAGE_FLASH_PAGE_SIZE) return false;
  if (address >= storage.flashSizeBytes || static_cast<uint64_t>(address) + length > storage.flashSizeBytes) return false;
  const uint16_t pageOffset = static_cast<uint16_t>(address & 0xFFUL);
  if (static_cast<uint32_t>(pageOffset) + length > STORAGE_FLASH_PAGE_SIZE) return false;
  if (!flashWriteEnable()) return false;
  SPI.beginTransaction(flashSpiSettings);
  storageCS(false);
  SPI.transfer(0x02);
  SPI.transfer(static_cast<uint8_t>(address >> 16));
  SPI.transfer(static_cast<uint8_t>(address >> 8));
  SPI.transfer(static_cast<uint8_t>(address));
  for (uint16_t i = 0; i < length; ++i) SPI.transfer(data[i]);
  storageCS(true);
  SPI.endTransaction();
  return flashWaitReady(1000UL);
}

bool flashProgramBytes(uint32_t address, const uint8_t *data, uint16_t length) {
  while (length > 0) {
    const uint16_t pageOffset = static_cast<uint16_t>(address & 0xFFUL);
    const uint16_t room = static_cast<uint16_t>(STORAGE_FLASH_PAGE_SIZE - pageOffset);
    const uint16_t chunk = (length < room) ? length : room;
    if (!flashProgramPage(address, data, chunk)) return false;
    address += chunk; data += chunk; length = static_cast<uint16_t>(length - chunk);
  }
  return true;
}

bool flashEraseSector(uint32_t sector) {
  if (!storage.detected || sector >= storage.sectorCount) return false;
  const uint32_t address = sector * STORAGE_FLASH_SECTOR_SIZE;
  if (!flashWriteEnable()) return false;
  SPI.beginTransaction(flashSpiSettings);
  storageCS(false);
  SPI.transfer(0x20);
  SPI.transfer(static_cast<uint8_t>(address >> 16));
  SPI.transfer(static_cast<uint8_t>(address >> 8));
  SPI.transfer(static_cast<uint8_t>(address));
  storageCS(true);
  SPI.endTransaction();
  return flashWaitReady(5000UL);
}

constexpr uint8_t STORAGE_BLANK_CHUNK_VERIFY_ATTEMPTS = 3;
constexpr uint16_t STORAGE_BLANK_CHUNK_RETRY_DELAY_MS = 2;

bool flashIsSectorBlank(uint32_t sector) {
  if (!storage.detected || sector >= storage.sectorCount) return false;
  uint8_t first[256];
  uint8_t second[256];
  uint8_t third[256];
  const uint32_t base = sector * STORAGE_FLASH_SECTOR_SIZE;
  for (uint16_t offset = 0; offset < STORAGE_FLASH_SECTOR_SIZE; offset += sizeof(first)) {
    bool chunkVerified = false;
    for (uint8_t attempt = 0; attempt < STORAGE_BLANK_CHUNK_VERIFY_ATTEMPTS; ++attempt) {
      if (attempt > 0) { delay(STORAGE_BLANK_CHUNK_RETRY_DELAY_MS); yield(); }
      if (!flashReadBytes(base + offset, first, sizeof(first)) ||
          !flashReadBytes(base + offset, second, sizeof(second)) ||
          memcmp(first, second, sizeof(first)) != 0) continue;
      if (!flashReadBytes(base + offset, third, sizeof(third)) ||
          memcmp(first, third, sizeof(first)) != 0) continue;
      bool allBlank = true;
      for (size_t i = 0; i < sizeof(first); ++i) if (first[i] != 0xFFU) { allBlank = false; break; }
      if (allBlank) { chunkVerified = true; break; }
    }
    if (!chunkVerified) return false;
    yield();
  }
  return true;
}

constexpr uint8_t STORAGE_ERASE_VERIFY_ATTEMPTS = 3;
constexpr uint8_t STORAGE_ERASE_POSTFAIL_VERIFY_ATTEMPTS = 3;
constexpr uint16_t STORAGE_ERASE_RETRY_DELAY_MS = 5;

bool flashEraseSectorVerified(uint32_t sector) {
  if (!storage.detected || sector >= storage.sectorCount) return false;
  if (flashIsSectorBlank(sector)) return true;
  for (uint8_t attempt = 0; attempt < STORAGE_ERASE_VERIFY_ATTEMPTS; ++attempt) {
    if (attempt > 0) { delay(STORAGE_ERASE_RETRY_DELAY_MS); yield(); }
    if (!flashWaitReady(5000UL)) continue;
    const bool eraseOk = flashEraseSector(sector);
    if (!eraseOk) continue;
    if (flashIsSectorBlank(sector)) return true;
    for (uint8_t verifyAttempt = 1; verifyAttempt < STORAGE_ERASE_POSTFAIL_VERIFY_ATTEMPTS; ++verifyAttempt) {
      delay(STORAGE_ERASE_RETRY_DELAY_MS); yield();
      if (flashIsSectorBlank(sector)) return true;
    }
  }
  return false;
}

bool flashReadJedec(uint8_t &manufacturer, uint8_t &memoryType, uint8_t &capacityCode) {
  SPI.beginTransaction(flashSpiSettings);
  storageCS(false);
  SPI.transfer(0x9F);
  manufacturer = SPI.transfer(0x00);
  memoryType = SPI.transfer(0x00);
  capacityCode = SPI.transfer(0x00);
  storageCS(true);
  SPI.endTransaction();
  return true;
}

uint32_t flashSizeFromCapacity(uint8_t capacityCode) {
  if (capacityCode == FLASH_CAPACITY_W25Qxx) return 4UL * 1024UL * 1024UL;
  if (capacityCode == FLASH_CAPACITY_W25Q64) return 8UL * 1024UL * 1024UL;
  return 0;
}

bool storageDetectFlash() {
  if (!flashReadJedec(storage.manufacturer, storage.memoryType, storage.capacityCode)) return false;
  storage.flashSizeBytes = flashSizeFromCapacity(storage.capacityCode);
  if (storage.manufacturer != FLASH_MANUFACTURER_WINBOND ||
      storage.memoryType != FLASH_MEMORY_TYPE_WINBOND_SERIAL_NOR ||
      storage.flashSizeBytes == 0) return false;
  storage.sectorCount = storage.flashSizeBytes / STORAGE_FLASH_SECTOR_SIZE;
  storage.detected = true;
  return true;
}

StableReadResult storageReadDatabaseHeaderStable(uint32_t sector, DatabaseHeader &header) {
  if (!storage.detected || sector >= storage.sectorCount) return StableReadResult::UNCERTAIN;
  uint8_t first[sizeof(DatabaseHeader)];
  uint8_t second[sizeof(DatabaseHeader)];
  const uint32_t address = sector * STORAGE_FLASH_SECTOR_SIZE;
  if (!flashReadBytes(address, first, sizeof(first)) ||
      !flashReadBytes(address, second, sizeof(second)) ||
      memcmp(first, second, sizeof(first)) != 0 ||
      !flashReadBytes(address, first, sizeof(first)) ||
      memcmp(first, second, sizeof(first)) != 0) return StableReadResult::UNCERTAIN;
  memcpy(&header, first, sizeof(header));
  if (header.magic != DB_MAGIC || header.formatVersion != STORAGE_FORMAT_VERSION ||
      header.headerSize != sizeof(DatabaseHeader) ||
      header.flashSizeBytes != storage.flashSizeBytes ||
      header.dataStartSector != DB_DATA_START_SECTOR ||
      header.generation == 0 || header.commit != COMMIT_MAGIC) return StableReadResult::INVALID;
  const uint32_t suppliedCrc = header.headerCrc32;
  const uint32_t suppliedCommit = header.commit;
  header.headerCrc32 = 0;
  header.commit = 0;
  const uint32_t calculated = crc32Bytes(reinterpret_cast<const uint8_t *>(&header), sizeof(header));
  header.headerCrc32 = suppliedCrc;
  header.commit = suppliedCommit;
  return suppliedCrc == calculated ? StableReadResult::VALID : StableReadResult::INVALID;
}

bool storageReadDatabaseHeader(uint32_t sector, DatabaseHeader &header) {
  return storageReadDatabaseHeaderStable(sector, header) == StableReadResult::VALID;
}

bool storageWriteDatabaseHeader(uint32_t sector, uint32_t generation) {
  if (!storage.detected || sector >= storage.sectorCount || generation == 0) return false;
  if (!flashEraseSectorVerified(sector)) return false;
  DatabaseHeader header{};
  header.magic = DB_MAGIC;
  header.formatVersion = STORAGE_FORMAT_VERSION;
  header.headerSize = sizeof(DatabaseHeader);
  header.flashSizeBytes = storage.flashSizeBytes;
  header.dataStartSector = DB_DATA_START_SECTOR;
  header.generation = generation;
  header.headerCrc32 = 0;
  header.reserved = 0;
  header.commit = 0;
  header.headerCrc32 = crc32Bytes(reinterpret_cast<const uint8_t *>(&header), sizeof(header));
  const uint32_t bodyLength = offsetof(DatabaseHeader, commit);
  if (!flashProgramBytes(sector * STORAGE_FLASH_SECTOR_SIZE,
                         reinterpret_cast<const uint8_t *>(&header),
                         static_cast<uint16_t>(bodyLength))) return false;
  DatabaseHeader verify{};
  if (!flashReadDatabaseHeaderWithoutCommit(sector, verify)) return false;
  const uint32_t commit = COMMIT_MAGIC;
  if (!flashProgramBytes(sector * STORAGE_FLASH_SECTOR_SIZE + offsetof(DatabaseHeader, commit),
                         reinterpret_cast<const uint8_t *>(&commit), sizeof(commit))) return false;
  for (uint8_t attempt = 0; attempt < 3; ++attempt) {
    DatabaseHeader finalVerify{};
    if (storageReadDatabaseHeader(sector, finalVerify) &&
        finalVerify.generation == generation) return true;
    delay(2);
  }
  return false;
}

bool flashReadDatabaseHeaderWithoutCommit(uint32_t sector, DatabaseHeader &header) {
  if (!storage.detected || sector >= storage.sectorCount) return false;
  uint8_t first[sizeof(DatabaseHeader)];
  uint8_t second[sizeof(DatabaseHeader)];
  const uint32_t address = sector * STORAGE_FLASH_SECTOR_SIZE;
  if (!flashReadBytes(address, first, sizeof(first)) ||
      !flashReadBytes(address, second, sizeof(second)) ||
      memcmp(first, second, sizeof(first)) != 0 ||
      !flashReadBytes(address, first, sizeof(first)) ||
      memcmp(first, second, sizeof(first)) != 0) return false;
  memcpy(&header, first, sizeof(header));
  if (header.magic != DB_MAGIC || header.formatVersion != STORAGE_FORMAT_VERSION ||
      header.headerSize != sizeof(DatabaseHeader) ||
      header.flashSizeBytes != storage.flashSizeBytes ||
      header.dataStartSector != DB_DATA_START_SECTOR ||
      header.generation == 0) return false;
  const uint32_t suppliedCrc = header.headerCrc32;
  const uint32_t suppliedCommit = header.commit;
  header.headerCrc32 = 0;
  header.commit = 0;
  const uint32_t calculated = crc32Bytes(reinterpret_cast<const uint8_t *>(&header), sizeof(header));
  header.headerCrc32 = suppliedCrc;
  header.commit = suppliedCommit;
  return suppliedCrc == calculated;
}

bool storageIsRecordHeaderBlank(const StorageRecordHeader &header) {
  const uint8_t *p = reinterpret_cast<const uint8_t *>(&header);
  for (size_t i = 0; i < sizeof(header); ++i) if (p[i] != 0xFFU) return false;
  return true;
}

bool storageReadRecordHeaderStable(uint32_t sector, StorageRecordHeader &header) {
  if (!storage.detected || sector >= storage.sectorCount) return false;
  uint8_t first[sizeof(StorageRecordHeader)];
  uint8_t second[sizeof(StorageRecordHeader)];
  const uint32_t address = sector * STORAGE_FLASH_SECTOR_SIZE;
  if (!flashReadBytes(address, first, sizeof(first)) ||
      !flashReadBytes(address, second, sizeof(second)) ||
      memcmp(first, second, sizeof(first)) != 0 ||
      !flashReadBytes(address, first, sizeof(first)) ||
      memcmp(first, second, sizeof(first)) != 0) return false;
  memcpy(&header, first, sizeof(header));
  return true;
}

bool storageReadCommitStable(uint32_t sector, uint32_t &commit) {
  if (!storage.detected || sector >= storage.sectorCount) return false;
  uint8_t first[sizeof(uint32_t)];
  uint8_t second[sizeof(uint32_t)];
  const uint32_t address = sector * STORAGE_FLASH_SECTOR_SIZE + STORAGE_COMMIT_OFFSET;
  if (!flashReadBytes(address, first, sizeof(first)) ||
      !flashReadBytes(address, second, sizeof(second)) ||
      memcmp(first, second, sizeof(first)) != 0 ||
      !flashReadBytes(address, first, sizeof(first)) ||
      memcmp(first, second, sizeof(first)) != 0) return false;
  memcpy(&commit, first, sizeof(commit));
  return true;
}

uint32_t crc32UpdateByte(uint32_t crc, uint8_t value) {
  crc ^= value;
  for (uint8_t bit = 0; bit < 8; ++bit) {
    const uint32_t mask = 0UL - (crc & 1UL);
    crc = (crc >> 1) ^ (0xEDB88320UL & mask);
  }
  return crc;
}

bool flashReadCrc32Streaming(uint32_t address, uint16_t length, uint32_t &crcOut) {
  if (!storage.detected || length == 0 || address >= storage.flashSizeBytes ||
      static_cast<uint64_t>(address) + length > storage.flashSizeBytes) return false;
  uint32_t crc = 0xFFFFFFFFUL;
  SPI.beginTransaction(flashSpiSettings);
  storageCS(false);
  SPI.transfer(0x03);
  SPI.transfer(static_cast<uint8_t>(address >> 16));
  SPI.transfer(static_cast<uint8_t>(address >> 8));
  SPI.transfer(static_cast<uint8_t>(address));
  for (uint16_t i = 0; i < length; ++i) {
    crc = crc32UpdateByte(crc, SPI.transfer(0x00));
    if ((i & 0xFFU) == 0xFFU) ESP.wdtFeed();
  }
  storageCS(true);
  SPI.endTransaction();
  crcOut = ~crc;
  return true;
}

PayloadVerifyResult storageReadPayloadStable(uint32_t sector, const StorageRecordHeader &header) {
  if (!storage.detected || sector >= storage.sectorCount || header.payloadLength > sizeof(storageRecordBuffer))
    return PayloadVerifyResult::CORRUPT;
  const uint32_t payloadAddress = sector * STORAGE_FLASH_SECTOR_SIZE + sizeof(StorageRecordHeader);
  if (static_cast<uint64_t>(payloadAddress) + header.payloadLength > storage.flashSizeBytes - 4ULL)
    return PayloadVerifyResult::CORRUPT;
  if (header.payloadLength == 0)
    return (header.payloadCrc32 == crc32Bytes(nullptr, 0)) ? PayloadVerifyResult::VALID : PayloadVerifyResult::CORRUPT;
  if (!flashReadBytes(payloadAddress, storageRecordBuffer, header.payloadLength))
    return PayloadVerifyResult::UNCERTAIN;
  const uint32_t crc1 = crc32Bytes(storageRecordBuffer, header.payloadLength);
  uint32_t crc2 = 0;
  if (!flashReadCrc32Streaming(payloadAddress, header.payloadLength, crc2)) return PayloadVerifyResult::UNCERTAIN;
  uint32_t crc3 = 0;
  if (!flashReadCrc32Streaming(payloadAddress, header.payloadLength, crc3)) return PayloadVerifyResult::UNCERTAIN;
  const uint32_t expected = header.payloadCrc32;
  const uint8_t expectedCount = static_cast<uint8_t>((crc1 == expected) + (crc2 == expected) + (crc3 == expected));
  if (expectedCount >= 2) {
    if (crc1 != expected) {
      if (!flashReadBytes(payloadAddress, storageRecordBuffer, header.payloadLength) ||
          crc32Bytes(storageRecordBuffer, header.payloadLength) != expected)
        return PayloadVerifyResult::UNCERTAIN;
    }
    return PayloadVerifyResult::VALID;
  }
  if (crc1 == crc2 && crc2 == crc3 && crc1 != expected) return PayloadVerifyResult::CORRUPT;
  return PayloadVerifyResult::UNCERTAIN;
}

bool storageReadPayloadVerifiedIntoBuffer(uint32_t sector, const StorageRecordHeader &header) {
  return storageReadPayloadStable(sector, header) == PayloadVerifyResult::VALID;
}

bool storageValidateRecordHeaderIntegrity(const StorageRecordHeader &header) {
  const uint32_t maxPhysicalIdentity = storageMaxPhysicalIdentity();
  if (header.magic != RECORD_MAGIC ||
      header.formatVersion != RECORD_FORMAT_VERSION ||
      header.flags != RECORD_FLAG_COMMITTED ||
      header.generation == 0 ||
      header.recordId == 0 ||
      header.sequence == 0 ||
      maxPhysicalIdentity == 0 ||
      header.sequence > maxPhysicalIdentity ||
      header.recordId > maxPhysicalIdentity ||
      (header.deviceId != 0 && header.deviceId > maxPhysicalIdentity) ||
      header.nameLength > STORAGE_MAX_NAME ||
      header.rawLength > RAW_WAVEFORM_CAPACITY ||
      header.payloadLength > (STORAGE_FLASH_SECTOR_SIZE - 4UL - sizeof(header)) ||
      static_cast<uint32_t>(header.nameLength) +
          static_cast<uint32_t>(header.rawLength) * sizeof(uint16_t) != header.payloadLength) return false;
  if (header.type == RECORD_TYPE_DEVICE) {
    if (header.rawLength != 0 || header.carrierHz != 0 || header.repeatCount != 0 ||
        header.repeatGapMs != 0 || header.deviceId == 0 ||
        header.deviceId != header.recordId || header.nameLength == 0) return false;
  } else if (header.type == RECORD_TYPE_COMMAND) {
    if (header.rawLength == 0 || header.nameLength == 0 || header.deviceId == 0 ||
        header.carrierHz < MIN_TX_FREQUENCY_HZ || header.repeatCount == 0) return false;
  } else if (header.type == RECORD_TYPE_DELETE_DEVICE) {
    if (header.nameLength != 0 || header.rawLength != 0 || header.carrierHz != 0 ||
        header.repeatCount != 0 || header.repeatGapMs != 0 || header.payloadLength != 0 ||
        header.deviceId == 0 || header.recordId == 0 || header.deviceId != header.recordId) return false;
  } else if (header.type == RECORD_TYPE_DELETE_COMMAND) {
    if (header.nameLength != 0 || header.rawLength != 0 || header.carrierHz != 0 ||
        header.repeatCount != 0 || header.repeatGapMs != 0 || header.payloadLength != 0 ||
        header.recordId == 0 || header.deviceId == 0) return false;
  } else if (header.type == RECORD_TYPE_RULE) {
    const bool sizeOk = (header.payloadLength == RULE_PAYLOAD_BYTES ||
                         header.payloadLength == RULE_PAYLOAD_BYTES_V1) &&
                        header.rawLength == (header.payloadLength / 2U);
    if (header.nameLength != 0 || header.deviceId != 0 || header.carrierHz != 0 ||
        header.repeatCount != 0 || header.repeatGapMs != 0 || !sizeOk) return false;

  } else if (header.type == RECORD_TYPE_DELETE_RULE) {
    if (header.nameLength != 0 || header.rawLength != 0 || header.carrierHz != 0 ||
        header.repeatCount != 0 || header.repeatGapMs != 0 || header.payloadLength != 0 ||
        header.deviceId != 0) return false;
  } else if (header.type == RECORD_TYPE_SCHEDULE) {
    if (header.nameLength != 0 || header.deviceId != 0 || header.carrierHz != 0 ||
        header.repeatCount != 0 || header.repeatGapMs != 0 ||
        header.rawLength != (SCHEDULE_PAYLOAD_BYTES / 2U) ||
        header.payloadLength != SCHEDULE_PAYLOAD_BYTES) return false;
  } else if (header.type == RECORD_TYPE_DELETE_SCHEDULE) {
    if (header.nameLength != 0 || header.rawLength != 0 || header.carrierHz != 0 ||
        header.repeatCount != 0 || header.repeatGapMs != 0 || header.payloadLength != 0 ||
        header.recordId == 0 || header.deviceId != 0) return false;
  } else if (header.type == RECORD_TYPE_ORDER) {
    if (header.nameLength != 0 || header.carrierHz != 0 ||
        header.repeatCount != 0 || header.repeatGapMs != 0 ||
        header.rawLength == 0U || header.rawLength > 64U ||
        header.payloadLength != header.rawLength * 2U) return false;        
  } else if (header.type == RECORD_TYPE_CONFIG_BACKUP) {
    if (header.nameLength != 0 || header.deviceId != 0 || header.carrierHz != 0 ||
        header.repeatCount != 0 || header.repeatGapMs != 0 ||
        header.payloadLength != STORAGE_CONFIG_BACKUP_PAYLOAD_BYTES ||
        header.rawLength != (STORAGE_CONFIG_BACKUP_PAYLOAD_BYTES / 2U)) return false;
  } else if (header.type == RECORD_TYPE_DEVICE_SETTINGS) {
    if (header.nameLength != 0 || header.deviceId != 0 || header.carrierHz != 0 ||
        header.repeatCount != 0 || header.repeatGapMs != 0 ||
        header.recordId == 0 ||
        header.payloadLength != 2U || header.rawLength != 1U) return false;
  } else if (header.type == RECORD_TYPE_COMMAND_SETTINGS) {
    if (header.nameLength != 0 || header.deviceId != 0 || header.carrierHz != 0 ||
        header.repeatCount != 0 || header.repeatGapMs != 0 ||
        header.recordId == 0 ||
        header.payloadLength != 2U || header.rawLength != 1U) return false;
  } else return false;
  StorageRecordHeader copy = header;
  const uint32_t supplied = copy.headerCrc32;
  copy.headerCrc32 = 0;
  const uint32_t calculated = crc32Bytes(reinterpret_cast<const uint8_t *>(&copy), sizeof(copy));
  return supplied == calculated;
}

bool storageValidateRecordHeader(const StorageRecordHeader &header) {
  return storageValidateRecordHeaderIntegrity(header) && header.generation == storage.generation;
}

bool storageHeaderHasPlausibleIdentity(const StorageRecordHeader &header) {
  const uint32_t maxPhysicalIdentity = storageMaxPhysicalIdentity();
  if (header.magic != RECORD_MAGIC || header.formatVersion != RECORD_FORMAT_VERSION ||
      header.generation == 0 || header.generation != storage.generation ||
      header.sequence == 0 || header.recordId == 0 || maxPhysicalIdentity == 0 ||
      header.sequence > maxPhysicalIdentity || header.recordId > maxPhysicalIdentity) return false;
  return true;
}

enum class DeviceLookupResult : uint8_t { NOT_FOUND, FOUND, CORRUPT_MATCH, READ_ERROR };
enum class CommandNameLookupResult : uint8_t { NOT_FOUND, FOUND, READ_ERROR };

CommandNameLookupResult storageFindCommandNameOnDevicePersistent(uint32_t deviceId, const char *name);
DeviceLookupResult storageLookupDeviceByName(const char *name, uint32_t &deviceIdOut);
bool storageEnsureFreeSpaceIndex();
bool storageFindVerifiedFreeSector(uint32_t startSector, uint32_t &sectorOut);
bool storageFindDeviceName(uint32_t deviceId, char *name, size_t nameCapacity);
bool storageFindDeviceNameIndexedOnly(uint32_t deviceId, char *name, size_t nameCapacity);
bool storageRebuildDeviceIndex();

bool storageGetRecordName(uint32_t sector, const StorageRecordHeader &header, char *name, size_t nameCapacity) {
  if (name == nullptr || nameCapacity == 0 || header.nameLength >= nameCapacity) return false;
  if (!storageReadPayloadVerifiedIntoBuffer(sector, header)) return false;
  memcpy(name, storageRecordBuffer, header.nameLength);
  name[header.nameLength] = '\0';
  return true;
}

bool storageReadValidatedRecord(uint32_t sector, StorageRecordHeader &header) {
  if (!storageReadRecordHeaderStable(sector, header) || storageIsRecordHeaderBlank(header)) return false;
  if (!storageValidateRecordHeader(header)) return false;
  if ((header.type == RECORD_TYPE_DEVICE && storageIsDeviceDeleted(header.recordId)) ||
      (header.type == RECORD_TYPE_COMMAND && (storageIsCommandDeleted(header.recordId) ||
       storageIsDeviceDeleted(header.deviceId)))) return false;
  uint32_t commit = 0;
  if (!storageReadCommitStable(sector, commit) || commit != COMMIT_MAGIC) return false;
  return storageReadPayloadVerifiedIntoBuffer(sector, header);
}

void storageReserveIdentityFromHeader(const StorageRecordHeader &header) {
  if (!storageHeaderHasPlausibleIdentity(header)) return;
  if (header.sequence != 0 && header.sequence > storage.maxSequence) storage.maxSequence = header.sequence;
  if (header.recordId != 0) {
    if (header.type == RECORD_TYPE_COMMAND) {
      if (header.recordId > storage.maxCommandId) storage.maxCommandId = header.recordId;
    } else if (header.type == RECORD_TYPE_DEVICE) {
      if (header.recordId > storage.maxDeviceId) storage.maxDeviceId = header.recordId;
    }
  }
  const uint32_t maxPhysicalIdentity = storageMaxPhysicalIdentity();
  if ((header.type == RECORD_TYPE_DEVICE || header.type == RECORD_TYPE_COMMAND) &&
      header.deviceId != 0 && header.deviceId <= maxPhysicalIdentity &&
      header.deviceId > storage.maxDeviceId) storage.maxDeviceId = header.deviceId;
}

// >>> FIX — small command-locator cache.
// Avoids a full 2000-sector flash scan on every press. The cached sector is
// always fully re-validated before use, so delete/rename/relearn invalidation
// happens automatically (the old sector stops validating).
// Small recent-command locator cache. A modest increase keeps the RAM cost
// low while making WebUI command presses far less likely to hit the full-flash
// lookup fallback. Each entry is 8 bytes.
constexpr uint8_t STORAGE_CMD_CACHE_SIZE = 16U;
struct CommandCacheEntry { uint32_t commandId; uint32_t sector; };
static CommandCacheEntry storageCommandCache[STORAGE_CMD_CACHE_SIZE] = {};
static uint8_t storageCommandCacheCursor = 0U;

static void storageResetCommandCache() {
  memset(storageCommandCache, 0, sizeof(storageCommandCache));
  storageCommandCacheCursor = 0U;
}

static void storageCacheCommandLocation(uint32_t commandId, uint32_t sector) {
  if (commandId == 0U) return;
  for (uint8_t i = 0U; i < STORAGE_CMD_CACHE_SIZE; ++i) {
    if (storageCommandCache[i].commandId == commandId) {
      storageCommandCache[i].sector = sector;
      return;
    }
  }
  storageCommandCache[storageCommandCacheCursor].commandId = commandId;
  storageCommandCache[storageCommandCacheCursor].sector    = sector;
  storageCommandCacheCursor =
      static_cast<uint8_t>((storageCommandCacheCursor + 1U) % STORAGE_CMD_CACHE_SIZE);
}

// ============================================================
// RAM ORDER CACHE + COMMAND INDEX
// ============================================================
// Both caches remove the full-flash scans that dominated WebUI latency.
// They are pure accelerators — every lookup re-validates against flash,
// so a stale entry is always harmless.

// ---- Device order list cache (recordId == 1, deviceId == 0)
// ---- Command order list cache (recordId == deviceId)
static uint16_t cachedDeviceOrder[64];
static uint16_t cachedDeviceOrderCount = 0;
static bool     cachedDeviceOrderValid = false;

static uint16_t cachedCmdOrderDevice = 0;
static uint16_t cachedCmdOrder[64];
static uint16_t cachedCmdOrderCount = 0;
static bool     cachedCmdOrderValid = false;

static void storageInvalidateOrderCache() {
  cachedDeviceOrderValid = false;
  cachedDeviceOrderCount = 0;
  cachedCmdOrderValid    = false;
  cachedCmdOrderCount    = 0;
  cachedCmdOrderDevice   = 0;
}

// ---- Live command index ------------------------------------------
// Every live command gets exactly one entry, pointing at its latest sector.
// Populated during storageScanDatabase() and maintained on writes.
struct CommandIndexEntry {
  uint16_t id;       // commandId  (fits because sectorCount <= 2048)
  uint16_t devId;    // deviceId
  uint16_t sector;   // flash sector holding the latest record
};
static_assert(sizeof(CommandIndexEntry) == 6, "unexpected CommandIndexEntry padding");

constexpr uint16_t STORAGE_CMD_INDEX_SIZE = 256U;
static CommandIndexEntry storageCommandIndex[STORAGE_CMD_INDEX_SIZE];
static uint16_t storageCommandIndexCount = 0;

static void storageResetCommandIndex() {
  memset(storageCommandIndex, 0, sizeof(storageCommandIndex));
  storageCommandIndexCount = 0;
}

static void storageRegisterCommandIndex(uint32_t commandId, uint32_t deviceId,
                                        uint32_t sector, uint32_t sequence) {
  (void)sequence;   // sequence only matters during the scan; the scan picks the winner
  if (commandId == 0U || deviceId == 0U ||
      commandId > 0xFFFFU || deviceId > 0xFFFFU ||
      sector >= STORAGE_MAX_SECTORS) return;

  // Already indexed? Overwrite (scan order already guarantees latest wins).
  for (uint16_t i = 0U; i < storageCommandIndexCount; ++i) {
    if (storageCommandIndex[i].id != (uint16_t)commandId) continue;
    storageCommandIndex[i].devId  = (uint16_t)deviceId;
    storageCommandIndex[i].sector = (uint16_t)sector;
    return;
  }
  if (storageCommandIndexCount >= STORAGE_CMD_INDEX_SIZE) return;
  CommandIndexEntry &e = storageCommandIndex[storageCommandIndexCount++];
  e.id     = (uint16_t)commandId;
  e.devId  = (uint16_t)deviceId;
  e.sector = (uint16_t)sector;
}

static void storageRemoveCommandIndex(uint32_t commandId) {
  if (commandId == 0U || commandId > 0xFFFFU) return;
  uint16_t w = 0U;
  for (uint16_t r = 0U; r < storageCommandIndexCount; ++r) {
    if (storageCommandIndex[r].id == (uint16_t)commandId) continue;
    if (w != r) storageCommandIndex[w] = storageCommandIndex[r];
    ++w;
  }
  storageCommandIndexCount = w;
}

void storageResetRuntimeDatabaseState() {
  storageResetCommandIndex();
  memset(storageQuarantineBitmap, 0, sizeof(storageQuarantineBitmap));
  memset(storageCommandAlexaBitmap, 0, sizeof(storageCommandAlexaBitmap));
  memset(storageDeviceCloudMap,     0, sizeof(storageDeviceCloudMap));
  memset(storageSeenDeviceIdBitmap, 0, sizeof(storageSeenDeviceIdBitmap));
  memset(storageDeviceIdConflictBitmap, 0, sizeof(storageDeviceIdConflictBitmap));
  memset(storageSeenCommandIdBitmap, 0, sizeof(storageSeenCommandIdBitmap));
  memset(storageCommandIdConflictBitmap, 0, sizeof(storageCommandIdConflictBitmap));
  memset(storageDeletedDeviceBitmap, 0, sizeof(storageDeletedDeviceBitmap));
  memset(storageDeletedCommandBitmap, 0, sizeof(storageDeletedCommandBitmap));
  storage.initialized = false;
  storage.headerCorrupt = false;
  storage.generation = 0;
  storage.maxSequence = 0;
  storage.maxCommandId = 0;
  storage.maxDeviceId = 0;
  storage.validRecordCount = 0;
  storage.corruptRecordCount = 0;
  storage.obsoleteRecordCount = 0;
  storage.usedSectorCount = 0;
  storage.freeSectorCount = 0;
  storage.firstFreeSector = UINT32_MAX;
  storage.freeSpaceIndexValid = false;
  storage.latestCommandSector = UINT32_MAX;
  storage.latestCommandId = 0;
  storage.latestCommandDeviceId = 0;
  storage.currentDeviceId = 0;
  storage.currentDeviceName[0] = '\0';
  storage.currentCommandId = 0;
  storage.currentCommandName[0] = '\0';
}

bool storageIsSectorQuarantined(uint32_t sector) {
  if (sector >= STORAGE_MAX_SECTORS) return false;
  return (storageQuarantineBitmap[sector >> 3] & static_cast<uint8_t>(1U << (sector & 7U))) != 0;
}
void storageMarkSectorQuarantined(uint32_t sector) {
  if (sector >= STORAGE_MAX_SECTORS) return;
  storageQuarantineBitmap[sector >> 3] |= static_cast<uint8_t>(1U << (sector & 7U));
}
void storageResetDeviceIndex() { storageDeviceIndexCount = 0; storageDeviceIndexReplaceCursor = 0; }

void storageRegisterDeviceIndex(uint32_t deviceId, uint32_t sector, uint16_t nameCrc, uint32_t sequence) {
  if (deviceId == 0 || storageIsDeviceIdentityConflicted(deviceId) ||
      sector >= STORAGE_MAX_SECTORS || storageIsSectorQuarantined(sector)) return;
  int bestIndex = -1;
  uint32_t bestCachedSequence = 0;
  for (uint16_t i = 0; i < storageDeviceIndexCount; ++i) {
    if (storageDeviceIndex[i].id != deviceId) continue;
    if (bestIndex < 0 || storageDeviceIndex[i].sequence > bestCachedSequence) {
      bestIndex = static_cast<int>(i);
      bestCachedSequence = storageDeviceIndex[i].sequence;
    }
  }
  if (bestIndex >= 0) {
    if (sequence > bestCachedSequence) {
      storageDeviceIndex[bestIndex].nameCrc = nameCrc;
      storageDeviceIndex[bestIndex].sector = static_cast<uint16_t>(sector);
      storageDeviceIndex[bestIndex].sequence = static_cast<uint16_t>(sequence);
    }
    return;
  }
  const DeviceIndexEntry entry{
    static_cast<uint16_t>(deviceId),
    static_cast<uint16_t>(sequence),
    static_cast<uint16_t>(sector),
    nameCrc
  };
  if (storageDeviceIndexCount < STORAGE_DEVICE_CACHE_SIZE) {
    storageDeviceIndex[storageDeviceIndexCount++] = entry;
    return;
  }
  storageDeviceIndex[storageDeviceIndexReplaceCursor] = entry;
  storageDeviceIndexReplaceCursor = static_cast<uint16_t>((storageDeviceIndexReplaceCursor + 1U) % STORAGE_DEVICE_CACHE_SIZE);
}

bool storageFindDeviceNameIndexedOnly(uint32_t deviceId, char *name, size_t nameCapacity) {
  if (!storage.initialized || deviceId == 0 || storageIsDeviceIdentityConflicted(deviceId) ||
      storageIsDeviceDeleted(deviceId) || name == nullptr || nameCapacity < 2) return false;
  int bestIndex = -1;
  uint32_t bestSequence = 0;
  for (uint16_t i = 0; i < storageDeviceIndexCount; ++i) {
    if (storageDeviceIndex[i].id != deviceId) continue;
    if (bestIndex < 0 || storageDeviceIndex[i].sequence > bestSequence) {
      bestIndex = static_cast<int>(i);
      bestSequence = storageDeviceIndex[i].sequence;
    }
  }
  if (bestIndex < 0) return false;
  const uint32_t indexedSector = storageDeviceIndex[bestIndex].sector;
  if (storageIsSectorQuarantined(indexedSector)) return false;
  StorageRecordHeader header{};
  if (!storageReadValidatedRecord(indexedSector, header) ||
      header.type != RECORD_TYPE_DEVICE || header.recordId != deviceId ||
      header.deviceId != deviceId || header.nameLength >= nameCapacity) return false;
  memcpy(name, storageRecordBuffer, header.nameLength);
  name[header.nameLength] = '\0';
  return true;
}

bool storageRebuildDeviceIndex() {
  if (!storage.initialized) return false;
  storageResetDeviceIndex();
  for (uint32_t sector = DB_DATA_START_SECTOR; sector < storage.sectorCount; ++sector) {
    feedWatchdog();
    if (storageIsSectorQuarantined(sector)) continue;
    StorageRecordHeader header{};
    if (!storageReadValidatedRecord(sector, header) || header.type != RECORD_TYPE_DEVICE ||
        storageIsDeviceDeleted(header.recordId) || header.nameLength == 0 ||
        header.deviceId != header.recordId) continue;
    storageRegisterDeviceIndex(header.recordId, sector,
        static_cast<uint16_t>(crc32Bytes(storageRecordBuffer, header.nameLength)),
        header.sequence);
  }
  return true;
}

bool storageRecoverDeviceIndexEntry(uint32_t deviceId) {
  if (!storage.initialized || deviceId == 0 || storageIsDeviceIdentityConflicted(deviceId)) return false;
  uint32_t bestSector = UINT32_MAX;
  uint32_t bestSequence = 0;
  uint16_t bestNameCrc = 0;
  for (uint32_t sector = DB_DATA_START_SECTOR; sector < storage.sectorCount; ++sector) {
    feedWatchdog();
    if (storageIsSectorQuarantined(sector)) continue;
    StorageRecordHeader header{};
    if (!storageReadValidatedRecord(sector, header) || header.type != RECORD_TYPE_DEVICE ||
        storageIsDeviceDeleted(deviceId) || header.recordId != deviceId ||
        header.deviceId != deviceId) continue;
    if (bestSector == UINT32_MAX || header.sequence > bestSequence) {
      bestSector = sector;
      bestSequence = header.sequence;
      bestNameCrc = static_cast<uint16_t>(crc32Bytes(storageRecordBuffer, header.nameLength));
    }
  }
  if (bestSector == UINT32_MAX) return false;
  storageRegisterDeviceIndex(deviceId, bestSector, bestNameCrc, bestSequence);
  char ignoredName[STORAGE_MAX_NAME + 1] = {0};
  return storageFindDeviceNameIndexedOnly(deviceId, ignoredName, sizeof(ignoredName));
}

bool storageHasIndexedValidDeviceId(uint32_t deviceId) {
  if (deviceId == 0 || storageIsDeviceIdentityConflicted(deviceId) ||
      storageIsDeviceDeleted(deviceId)) return false;
  char ignoredName[STORAGE_MAX_NAME + 1] = {0};
  return storageFindDeviceNameIndexedOnly(deviceId, ignoredName, sizeof(ignoredName));
}

uint32_t storageMaxPhysicalIdentity() {
  return (storage.sectorCount > DB_DATA_START_SECTOR) ? (storage.sectorCount - DB_DATA_START_SECTOR) : 0;
}

bool storageIdentityBitmapContains(const uint8_t *bitmap, uint32_t id) {
  const uint32_t maxId = storageMaxPhysicalIdentity();
  if (bitmap == nullptr || id == 0 || id > maxId || id >= STORAGE_MAX_SECTORS) return false;
  return (bitmap[id >> 3] & static_cast<uint8_t>(1U << (id & 7U))) != 0;
}
void storageIdentityBitmapSet(uint8_t *bitmap, uint32_t id) {
  const uint32_t maxId = storageMaxPhysicalIdentity();
  if (bitmap == nullptr || id == 0 || id > maxId || id >= STORAGE_MAX_SECTORS) return;
  bitmap[id >> 3] |= static_cast<uint8_t>(1U << (id & 7U));
}
bool storageIsDeviceIdentityConflicted(uint32_t deviceId) { return storageIdentityBitmapContains(storageDeviceIdConflictBitmap, deviceId); }
bool storageIsCommandIdentityConflicted(uint32_t commandId) { return storageIdentityBitmapContains(storageCommandIdConflictBitmap, commandId); }
void storageMarkDeviceIdentitySeen(uint32_t deviceId) { storageIdentityBitmapSet(storageSeenDeviceIdBitmap, deviceId); }
bool storageWasDeviceIdentitySeen(uint32_t deviceId) { return storageIdentityBitmapContains(storageSeenDeviceIdBitmap, deviceId); }
void storageMarkDeviceIdentityConflicted(uint32_t deviceId) { storageIdentityBitmapSet(storageDeviceIdConflictBitmap, deviceId); }
bool storageWasCommandIdentitySeen(uint32_t commandId) { return storageIdentityBitmapContains(storageSeenCommandIdBitmap, commandId); }
void storageMarkCommandIdentitySeen(uint32_t commandId) { storageIdentityBitmapSet(storageSeenCommandIdBitmap, commandId); }
void storageMarkCommandIdentityConflicted(uint32_t commandId) { storageIdentityBitmapSet(storageCommandIdConflictBitmap, commandId); }
bool storageIsDeviceDeleted(uint32_t deviceId) { return storageIdentityBitmapContains(storageDeletedDeviceBitmap, deviceId); }
bool storageIsCommandDeleted(uint32_t commandId) { return storageIdentityBitmapContains(storageDeletedCommandBitmap, commandId); }

void storageRemoveDeviceIndexEntries(uint32_t deviceId) {
  uint16_t writeIndex = 0;
  for (uint16_t readIndex = 0; readIndex < storageDeviceIndexCount; ++readIndex) {
    if (storageDeviceIndex[readIndex].id == deviceId) continue;
    if (writeIndex != readIndex) storageDeviceIndex[writeIndex] = storageDeviceIndex[readIndex];
    ++writeIndex;
  }
  storageDeviceIndexCount = writeIndex;
  if (storageDeviceIndexReplaceCursor >= storageDeviceIndexCount &&
      storageDeviceIndexCount < STORAGE_DEVICE_CACHE_SIZE) storageDeviceIndexReplaceCursor = storageDeviceIndexCount;
}

void storageResetScanState() {
  storageResetDeviceIndex();
  storageResetCommandIndex();       // >>> NEW — rebuild index from scratch
  storageInvalidateOrderCache();    // >>> NEW — force re-read of order records
  memset(storageCommandAlexaBitmap, 0, sizeof(storageCommandAlexaBitmap));
  memset(storageDeviceCloudMap,     0, sizeof(storageDeviceCloudMap));
  memset(storageSeenDeviceIdBitmap, 0, sizeof(storageSeenDeviceIdBitmap));
  memset(storageDeviceIdConflictBitmap, 0, sizeof(storageDeviceIdConflictBitmap));
  memset(storageSeenCommandIdBitmap, 0, sizeof(storageSeenCommandIdBitmap));
  memset(storageCommandIdConflictBitmap, 0, sizeof(storageCommandIdConflictBitmap));
  memset(storageDeletedDeviceBitmap, 0, sizeof(storageDeletedDeviceBitmap));
  memset(storageDeletedCommandBitmap, 0, sizeof(storageDeletedCommandBitmap));
  storage.maxSequence = 0;
  storage.maxCommandId = 0;
  storage.maxDeviceId = 0;
  storage.validRecordCount = 0;
  storage.corruptRecordCount = 0;
  storage.obsoleteRecordCount = 0;
  storage.usedSectorCount = 0;
  storage.freeSectorCount = 0;
  storage.firstFreeSector = UINT32_MAX;
  storage.freeSpaceIndexValid = false;
  storage.latestCommandSector = UINT32_MAX;
  storage.latestCommandId = 0;
  storage.latestCommandDeviceId = 0;
}

bool storageTryReclaimUncommittedSector(uint32_t sector, const StorageRecordHeader &header) {
  uint32_t commit = 0;
  if (!storageReadCommitStable(sector, commit) || commit != 0xFFFFFFFFUL) {
    storageQuarantineSector(sector); return false;
  }
  if (!storageValidateRecordHeaderForBody(&header, storage.generation)) {
    storageQuarantineSector(sector); return false;
  }
  const PayloadVerifyResult payloadResult = storageReadPayloadStable(sector, header);
  if (payloadResult == PayloadVerifyResult::UNCERTAIN) { storageQuarantineSector(sector); return false; }
  if (!flashEraseSectorVerified(sector)) { storageQuarantineSector(sector); return false; }
  return true;
}
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
void loop() {
  feedWatchdog();
  otaService(); 
   if (wifiRecoveryState != WifiRecoveryState::OFF) {
    captiveDnsService();   // ← add this line
    // (wifiService() still runs, otherwise we can't detect recovery)
  } 
  wifiService();
  statusLedServiceWifiErrorDelay();   // >>> v1.0

  // Service the existing port-80 HTTP/Hue server as early as possible. This
  // keeps WebUI button presses and navigation from waiting behind the slower
  // background services below. The same single Hue/WebUI server is used.
  hueService();

  wifiWatchdogService();
  timeService();
  statusLedService();
  ds18b20Service();
  mqttService();
  mqttServiceAlexaDirective();
  storageJobService();          // ← add this
  webUiServiceLearning();
  webUiServiceWifiScan();
  webUiServiceWifiApply();
  automationService();

#if STAGE1_SERIAL_DEBUG
  serviceSerial();
#endif

  updateMinimumHeap();
}
