sheminasalam/OverKill-Smart-IR-Hub/(commit log)

2026-10-25 docs: add hardware/PIN-MAP.md
2026-10-25 docs: add visual firmware pin-map review
2026-10-25 docs: link the pin-map review graphic
2026-10-25 docs: align docs/HARDWARE.md with current source
2026-10-25 docs: align hardware/PIN-MAP.md with current source
2026-10-25 docs: align docs/ALEXA_AWS.md with current source
2026-10-25 docs: correct firmware pin-conflict description
2026-10-25 docs: correct AWS IoT topic-filter policy ARN
2026-10-25 docs: add exact purchased parts and supplier links to BOM
2026-10-25 docs: document exact purchased components and IR current verification
2026-10-25 docs: avoid assuming generic IR LED current rating
2026-10-25 docs: specify PETG for the enclosure print
2026-10-25 docs: add labeled render of the enclosure 3MF
2026-10-25 docs: show labeled 3MF render and specify PETG printing
2026-10-25 docs: add labeled enclosure preview and PETG instructions
2026-10-25 docs: create enclosure model and PETG print instructions
2026-10-25 docs: link enclosure PETG guide from project README
2026-10-25 docs: document D1 mini, USB-C power, sensor ports and underside reset
2026-10-25 docs: correct BOM for actual D1 mini and USB-C power build
2026-10-25 docs: correct pin map for D1 mini and physical controls
2026-10-25 docs: explain enclosure openings, USB-C power and reset placement
2026-10-25 docs: correct enclosure labels for sensors USB-C and reset
2026-10-25 docs: label the third top-plate opening as status LED
2026-10-25 docs: align pin review with D1 mini and actual enclosure controls
2026-10-25 docs: align assembly steps with D1 mini USB-C and physical controls
2026-10-25 docs: describe D1 mini enclosure controls and committed 3MF
2026-10-25 docs: document actual enclosure provisions and PETG build
2026-10-25 docs: align firmware setup with D1 mini and no learn button
2026-10-25 docs: fit enclosure label diagram footer text
2026-10-25 docs: add updated ESP-12F connection schematic
2026-10-25 docs: link ESP-12F schematic and flag D1 mini UART conflict
2026-10-25 docs: reference corrected enclosure and connection images
2026-10-25 docs: foreground low-cost local hub positioning and BOM subtotal
2026-10-25 docs: align hardware guide with current circuit and enclosure images
2026-10-25 docs: replace outdated pin-map notes with current diagram
2026-10-25 docs: update release blockers for current hardware
2026-10-25 docs: showcase existing enclosure and circuit images on landing page
2026-10-25 docs: replace stale integration plan with current setup guide
2026-10-25 docs: clarify single LED and GPIO/RST wiring
2026-10-25 docs: clarify intended pin map and unverified hardware tests
2026-10-25 fix: correct stale flash CS diagnostic to GPIO3
    [OverKill-v1.ino]
2026-10-25 fix: remove unused learn GPIO initialization
    [OverKill-v1.ino]
2026-10-25 docs: align pin map BOM and diagnostic notes
2026-10-25 docs: document build settings and corrected pin mapping
